AlessandroAU/Chorus32-ESP32LapTimer/data/laptimer comparison.pdf

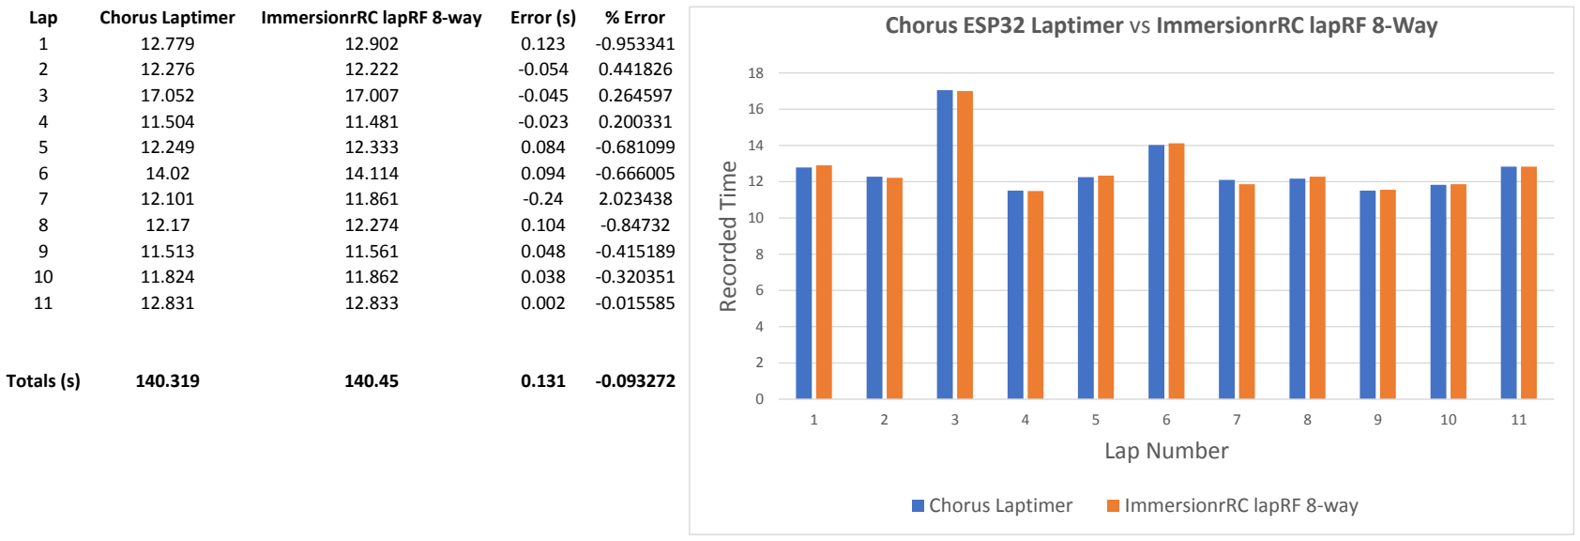
[picture p8: figure]
Lap; Chorus Laptimer; ImmersionrRC lapRF 8-way; Error (s); % Error; Totals (s); Recorded Time; Lap Number

### Chorus ESP32 Laptimer vs ImmersionrRC lapRF 8-Way
