AlessandroAU/Chorus32-ESP32LapTimer/img/hardwareImage1.png

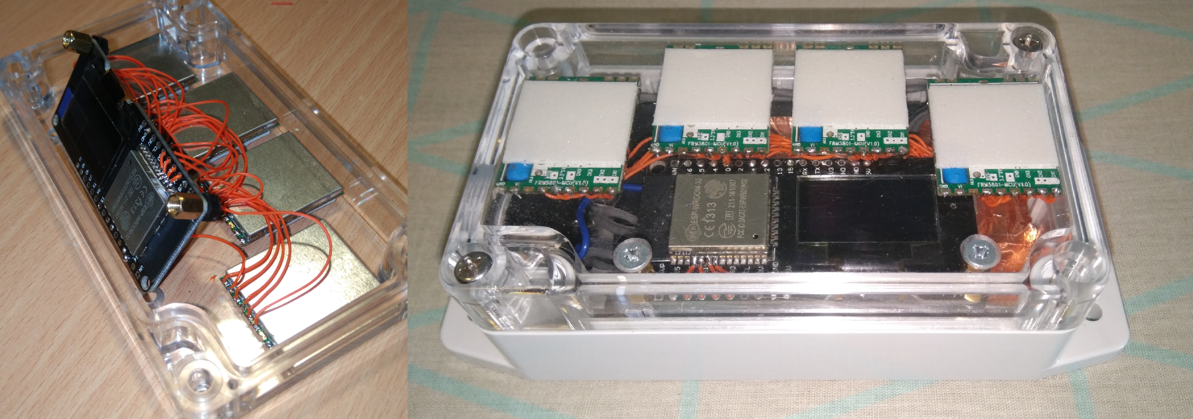
img/hardwareImage1.png
