AlessandroAU/Chorus32-ESP32LapTimer/img/HardwareImage2.png

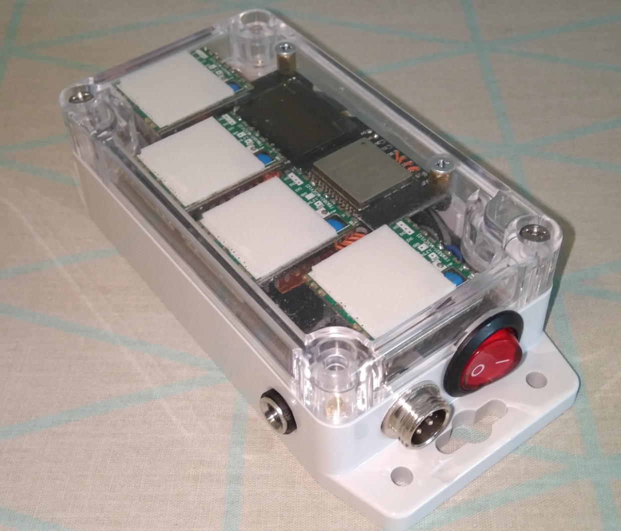
img/HardwareImage2.png
