AlessandroAU/Chorus32-ESP32LapTimer/img/schematic2.png

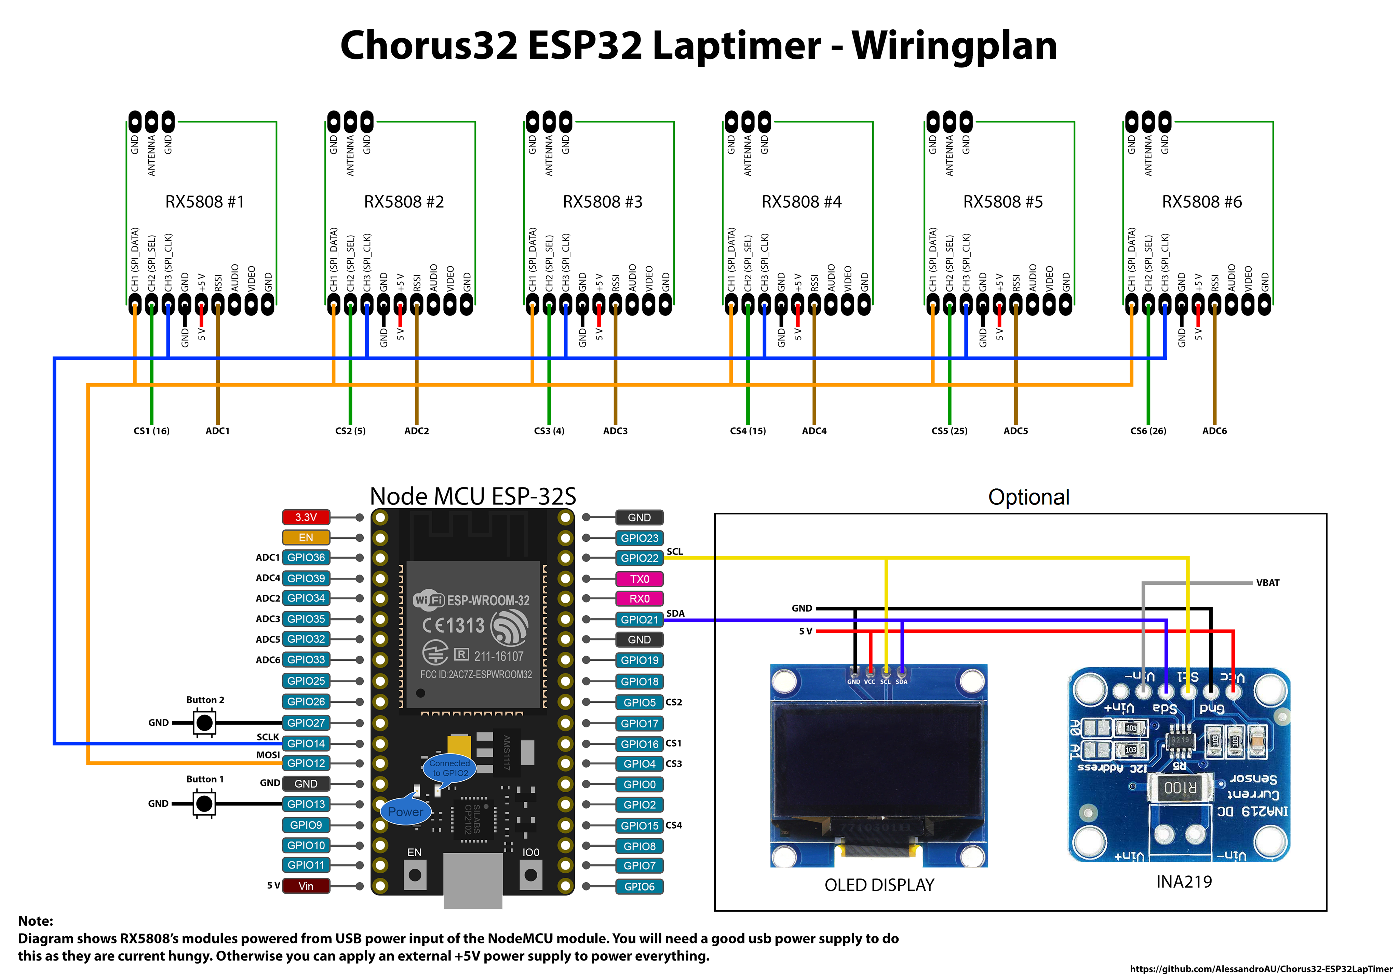
img/schematic2.png
