AlessandroAU/Chorus32-ESP32LapTimer/pcb/JyeSmith/PCBV2.1/PCB-2.1 - Patch Wire.png

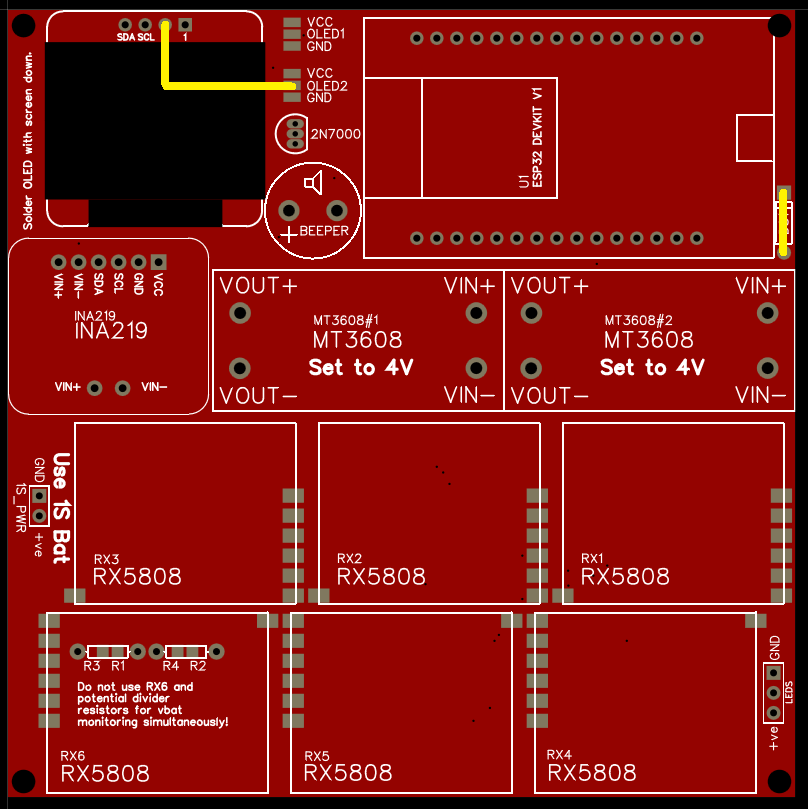
pcb/JyeSmith/PCBV2.1/PCB-2.1 - Patch Wire.png
