AlessandroAU/Chorus32-ESP32LapTimer/pcb/JyeSmith/PCBV2.1/Schematic-V2.1.png

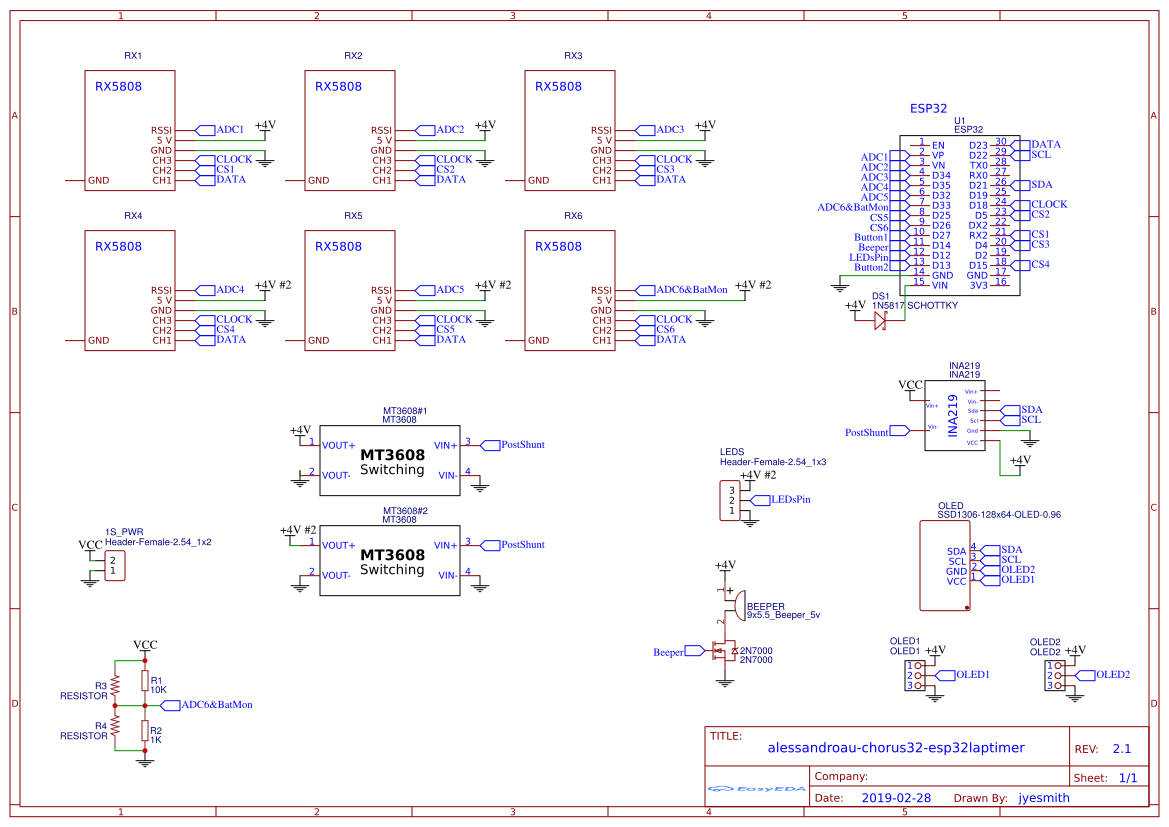
pcb/JyeSmith/PCBV2.1/Schematic-V2.1.png
