AlessandroAU/Chorus32-ESP32LapTimer/pcb/JyeSmith/PCBV2.2/PCB-2.2.png

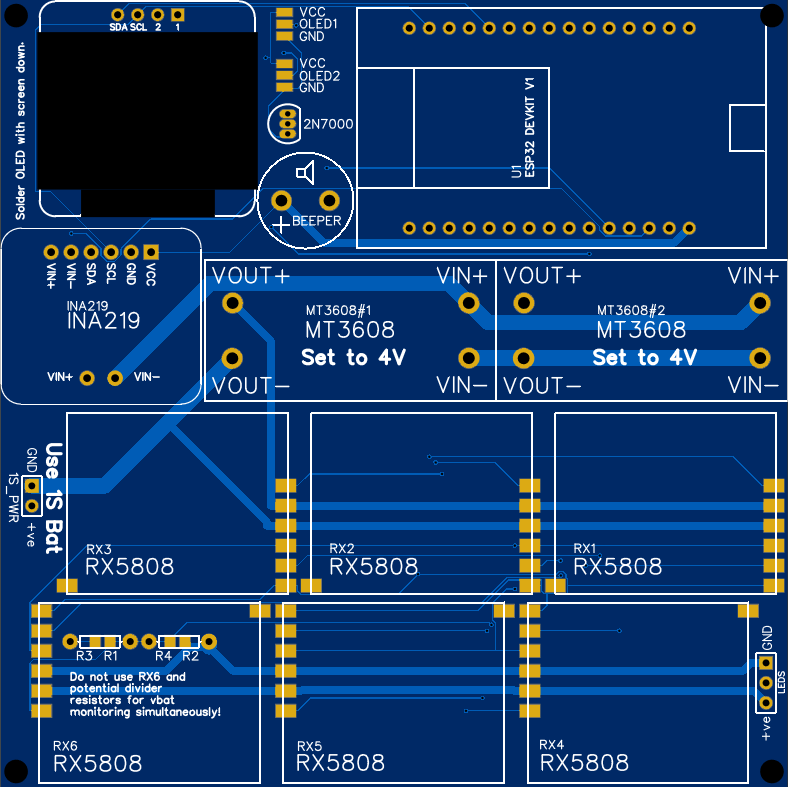
pcb/JyeSmith/PCBV2.2/PCB-2.2.png
