AlessandroAU/Chorus32-ESP32LapTimer/img/wiring.png

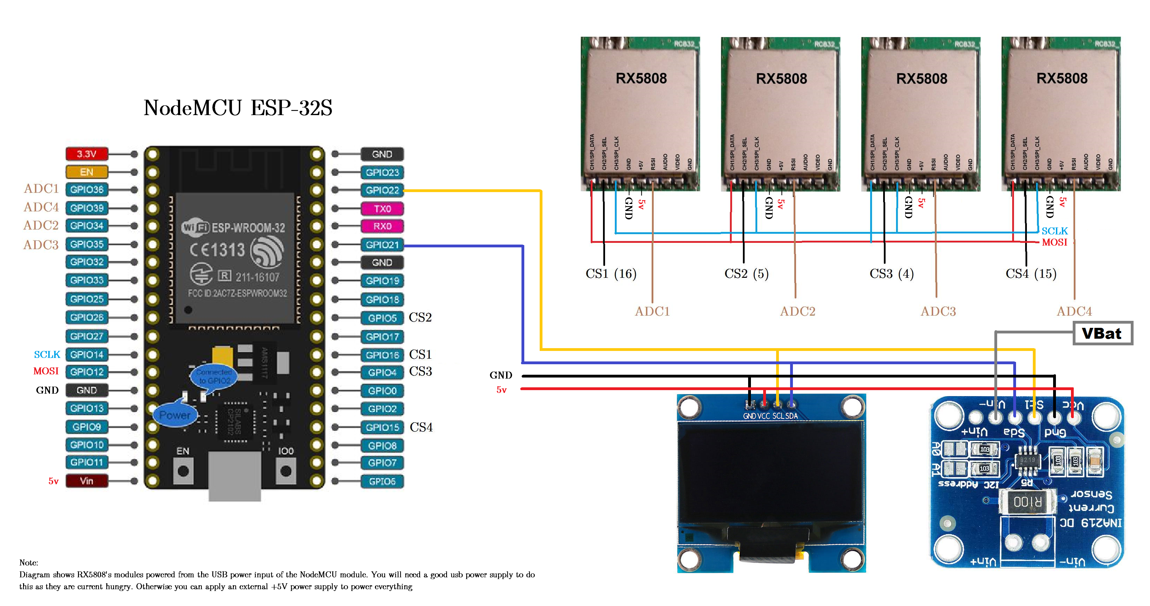
img/wiring.png
