AlessandroAU/Chorus32-ESP32LapTimer/(threads)

Thread 1 (2018-12-01):

Wifi drop

mmoustache, 2018-12-01:
Hi, after flashing scetch in Network manager i see Chorus LapTimer wifi. Connecting, and after 2 second my connection is dropping and phone trying another wifi net. Im Using DOIT ESP32 DEVKIT 1.
My flash log is below:

 Build options changed, rebuilding all
Archiving built core (caching) in: /var/folders/vh/7yvqz7hs4mb3hx6h7yhhwkgh0000gn/T/arduino_cache_787905/core/core_esp32_esp32_esp32_PSRAM_disabled,PartitionScheme_min_spiffs,FlashMode_qio,FlashFreq_80,FlashSize_4M,UploadSpeed_115200,DebugLevel_none_c000cfe2de910e434d508ffe474b5bc9.a
Sketch uses 1328918 bytes (67%) of program storage space. Maximum is 1966080 bytes.
Global variables use 82732 bytes (25%) of dynamic memory, leaving 244948 bytes for local variables. Maximum is 327680 bytes.
esptool.py v2.3.1
Connecting........__
Chip is ESP32D0WDQ6 (revision 1)
Features: WiFi, BT, Dual Core
Uploading stub...
Running stub...
Stub running...
Configuring flash size...
Auto-detected Flash size: 4MB
Compressed 8192 bytes to 47...

Writing at 0x0000e000... (100 %)
Wrote 8192 bytes (47 compressed) at 0x0000e000 in 0.0 seconds (effective 8221.8 kbit/s)...
Hash of data verified.
Compressed 15072 bytes to 9733...

Writing at 0x00001000... (100 %)
Wrote 15072 bytes (9733 compressed) at 0x00001000 in 0.9 seconds (effective 139.9 kbit/s)...
Hash of data verified.
Compressed 1329056 bytes to 779928...

Writing at 0x00010000... (2 %)
Writing at 0x00014000... (4 %)
Writing at 0x00018000... (6 %)
Writing at 0x0001c000... (8 %)
Writing at 0x00020000... (10 %)
Writing at 0x00024000... (12 %)
Writing at 0x00028000... (14 %)
Writing at 0x0002c000... (16 %)
Writing at 0x00030000... (18 %)
Writing at 0x00034000... (20 %)
Writing at 0x00038000... (22 %)
Writing at 0x0003c000... (25 %)
Writing at 0x00040000... (27 %)
Writing at 0x00044000... (29 %)
Writing at 0x00048000... (31 %)
Writing at 0x0004c000... (33 %)
Writing at 0x00050000... (35 %)
Writing at 0x00054000... (37 %)
Writing at 0x00058000... (39 %)
Writing at 0x0005c000... (41 %)
Writing at 0x00060000... (43 %)
Writing at 0x00064000... (45 %)
Writing at 0x00068000... (47 %)
Writing at 0x0006c000... (50 %)
Writing at 0x00070000... (52 %)
Writing at 0x00074000... (54 %)
Writing at 0x00078000... (56 %)
Writing at 0x0007c000... (58 %)
Writing at 0x00080000... (60 %)
Writing at 0x00084000... (62 %)
Writing at 0x00088000... (64 %)
Writing at 0x0008c000... (66 %)
Writing at 0x00090000... (68 %)
Writing at 0x00094000... (70 %)
Writing at 0x00098000... (72 %)
Writing at 0x0009c000... (75 %)
Writing at 0x000a0000... (77 %)
Writing at 0x000a4000... (79 %)
Writing at 0x000a8000... (81 %)
Writing at 0x000ac000... (83 %)
Writing at 0x000b0000... (85 %)
Writing at 0x000b4000... (87 %)
Writing at 0x000b8000... (89 %)
Writing at 0x000bc000... (91 %)
Writing at 0x000c0000... (93 %)
Writing at 0x000c4000... (95 %)
Writing at 0x000c8000... (97 %)
Writing at 0x000cc000... (100 %)
Wrote 1329056 bytes (779928 compressed) at 0x00010000 in 69.0 seconds (effective 154.0 kbit/s)...
Hash of data verified.
Compressed 3072 bytes to 144...

Writing at 0x00008000... (100 %)
Wrote 3072 bytes (144 compressed) at 0x00008000 in 0.0 seconds (effective 1452.8 kbit/s)...
Hash of data verified.

Leaving...
Hard resetting via RTS pin...

AlessandroAU, 2018-12-01:
Hi, you upload the serial log when you try to connect to WiFi?

mmoustache, 2018-12-02:
Hi, serial log says that, maybe it happend beacuase i justa flashed ESP32 and not connected receivers?

Ready! Open http://esp32-webupdate.local in your browser
Ready
IP address: 0.0.0.0
setModuleChannelBand
0,4
32
a = 5740
setModuleChannelBand
2,4
34
a = 5780
setModuleChannelBand
4,4
36
a = 5820
setModuleChannelBand
6,4
38
a = 5860
Guru Meditation Error: Core  1 panic'ed (Cache disabled but cached memory region accessed)
Core 1 register dump:
PC      : 0x400dd628  PS      : 0x00060034  A0      : 0x800817e4  A1      : 0x3ffc0bd0
A2      : 0x00000000  A3      : 0x20000000  A4      : 0x00000400  A5      : 0x3ffc5bb4
A6      : 0x3ffc4d40  A7      : 0xffffffff  A8      : 0x80081290  A9      : 0x3ffc0bb0
A10     : 0x00000000  A11     : 0xffffffff  A12     : 0x3ffd69ec  A13     : 0x000000ff
A14     : 0x3ffc63c0  A15     : 0x00060a23  SAR     : 0x00000014  EXCCAUSE: 0x00000007
EXCVADDR: 0x00000000  LBEG    : 0x00000000  LEND    : 0x00000000  LCOUNT  : 0x00000000
Core 1 was running in ISR context:
EPC1    : 0x40082f73  EPC2    : 0x00000000  EPC3    : 0x00000000  EPC4    : 0x400dd628

Backtrace: 0x400dd628:0x3ffc0bd0 0x400817e1:0x3ffc0bf0 0x40081cd9:0x3ffc0c10 0x40082f70:0x00000000

Rebooting...

AlessandroAU, 2018-12-02:
Seems to be crashing during the ISR loop when reading ADCs, should not be happening. I will have a look.

AlessandroAU, 2018-12-07:
Appears to be a conflict between wifi and bluetooth stacks, fixed for now by disabling BLE by default in latest commit. BLE can be re-enabled by uncommenting compiler option //#define BluetoothEnabled

Closed 2018-12-07.

Thread 2 (2019-02-03):

File ESPmDNS.h is missing for compile/upload

mottex, 2019-02-03:
I try to upload the laptimer code, but arduino ide - gives the following error message:

ESP32LapTimer:7:21: error: ESPmDNS.h: No such file or directory

compilation terminated.

exit status 1
ESPmDNS.h: No such file or directory

Thanks for your help

AlessandroAU, 2019-02-03:
You will need to install all the libraries required. You should be able to do it through the library manager
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

mottex, 2019-02-03:
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

Unfortunately it is not shown.... any other suggestions?

AlessandroAU, 2019-02-03:
I would do I fresh install of the esp32 files through board manager to ensure you're not having issues because of old code

mottex, 2019-02-03:
Thanks for your help! I have internet connection problems, which caused the above message.

Now, i got the message - comms.h -
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
 is missing. Do i have to include an other library? (the File comms.h is in the project folder).

AlessandroAU, 2019-02-04:
You need to make sure that all the files are in the same folder and that the folder is called "ESP32LapTimer" ie same as the main arduino .ino file.

mottex, 2019-02-04:
Thanx allessandro! Can be closef

Closed 2019-02-04.

Thread 3 (2019-02-05):

Hardware

LuisDiazUgena, 2019-02-05:
Hi!

I was wondering if you can share a link to the board that you're using to built this.

TY.

AlessandroAU, 2019-02-07:
Hi, most ESP32 boards will work. I used an OLED board but I would recommend a standard nodeMCU ESP-32s as it will probably become the standard.

LuisDiazUgena, 2019-02-07:
Ok, no problem. Will take a look at which boards are available and choose one. I think maybe it will be interesting to make a custom pcb board to solder on the ESP32 IC and the VRX. Also, by adding some simple power management stuff, could be a nice project to work with.

Also, could be nice to keep info about how to create and wire up the project.

AlessandroAU, 2019-02-08:
Hi, I added a wiring diagram for the NodeMCU ESP32s
https://github.com/AlessandroAU/Chorus32-ESP32LapTimer/blob/master/wiring.png

LuisDiazUgena, 2019-02-08:
Thanks

shirishyc, 2019-02-08:
Thanks

Closed 2019-02-08.

Thread 4 (2019-02-07):

Connection Diagram needed

shirishyc, 2019-02-07:
Hi

I want to use an OLED board for this Project.
So can you provide Connection diagram for connecting ESP32 and RX5808 module

Sorry I don't know how to contact you for further Info about this Project.
Waiting for your reply

Thanks in Advance
SHIRISH

LuisDiazUgena, 2019-02-07:
Regarding the oled:

For connecting the OLED you shoul use the rigth port on the node MCU, I think most of oled uses SCL/SDA to interface with the OLED.

Google for "your_board_name_here pinout" and look for SCL/SDA.

AlessandroAU, 2019-02-08:
Hi, recommend you don't use the esp32 oled board because not all the ADC pins are broken out. At the moment the oled does nothing. The NodeMCU ESP32s is easier to wire up. I have added a wiring diagram to the main page.

https://github.com/AlessandroAU/Chorus32-ESP32LapTimer/blob/master/wiring.png

shirishyc, 2019-02-08:
Thanks a lot for updating Git repo with wiring diagram.
Will work accordingly..

shirishyc, 2019-02-10:
Hi,
I have compiled uploaded into ESP32.
But having small question, What file need to upload in WebServer.
Im unble to figure out.. Can you let me know sample file for the same.. or can you upload into repo.
Im attaching screenshot for ref.

Waiting for reply
Thanks
SHIRISH

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

AlessandroAU, 2019-02-10:
You don't need to upload anything, that is for a future version where you will be able to update the firmware by uploading a file.

It should be working, check to see if you can make a connection with the app.

shirishyc, 2019-02-10:
Ok Great Thanks.
Im able to connect to App. But unable to add pilots name..
is I'm missing something to do..

AlessandroAU, 2019-02-10:
Can you show me the serial console in Arduino when you connect to the board from the app?

AlessandroAU, 2019-02-12:
Did you get it working?

shirishyc, 2019-02-13:
Yes.. Its Perfectly Working Fine..
I just mess with some Wires thts why Unable to do.!
But Now working Fine.

Thanks for Awesome Code.

1que Can We run web server from ESP32

AlessandroAU, 2019-02-13:
This is possible, but it would be alot of work and web design is not my area of expertise. I think it is too hard for the moment.

marcfon, 2020-04-30:
In case someone is searching for the wiring diagram... The link has changed to this:  https://github.com/AlessandroAU/Chorus32-ESP32LapTimer/blob/master/img/wiring.png

Closed 2019-02-13.

Thread 23 (2019-03-07):

Unable to connect to wifi configurator

LuisDiazUgena, 2019-03-07:
Hi!

I was trying to use this project and I'm not being able to connect to the wifi configurator.

I've flashed the code with no issues. Also flashed href=\"https://github.com/me-no-dev/arduino-esp32fs-plugin pluging and uploaded esp32 sketch data.

I can connect to wifi AP, but android doesn't ask me to sign in the network. I've looked into the code, and the wifi AP seems to be 192.168.1.4, so I've tried to log using chrome, not luck again.

Here is my serial monitor output.
```
ets Jun  8 2016 00:22:57

rst:0x1 (POWERON_RESET),boot:0x13 (SPI_FAST_FLASH_BOOT)
configsip: 0, SPIWP:0xee
clk_drv:0x00,q_drv:0x00,d_drv:0x00,cs0_drv:0x00,hd_drv:0x00,wp_drv:0x00
mode:DIO, clock div:1
load:0x3fff0018,len:4
load:0x3fff001c,len:1100
load:0x40078000,len:10088
load:0x40080400,len:6380
entry 0x400806a4
[V][esp32-hal-i2c.c:1483] i2cInit(): num=0 sda=21 scl=22 freq=0
[V][esp32-hal-i2c.c:1677] i2cSetFrequency(): freq=100000Hz
[V][esp32-hal-i2c.c:1692] i2cSetFrequency(): cpu Freq=240Mhz, i2c Freq=100000Hz
[V][esp32-hal-i2c.c:1698] i2cSetFrequency(): Fifo delta=1
[V][esp32-hal-i2c.c:1677] i2cSetFrequency(): freq=700000Hz
[V][esp32-hal-i2c.c:1692] i2cSetFrequency(): cpu Freq=240Mhz, i2c Freq=700000Hz
[V][esp32-hal-i2c.c:1698] i2cSetFrequency(): Fifo delta=5
Booting....
EEPROM LOADED
6
6
[V][esp32-hal-i2c.c:1483] i2cInit(): num=0 sda=21 scl=22 freq=0
[V][esp32-hal-i2c.c:1677] i2cSetFrequency(): freq=701754Hz
[V][esp32-hal-i2c.c:1692] i2cSetFrequency(): cpu Freq=240Mhz, i2c Freq=701754Hz
[V][esp32-hal-i2c.c:1698] i2cSetFrequency(): Fifo delta=5
off
[D][WiFiGeneric.cpp:342] _eventCallback(): Event: 0 - WIFI_READY
[D][WiFiGeneric.cpp:342] _eventCallback(): Event: 14 - AP_STOP
[E][WiFiSTA.cpp:211] begin(): connect failed!
[D][WiFiGeneric.cpp:342] _eventCallback(): Event: 2 - STA_START
[D][WiFiGeneric.cpp:342] _eventCallback(): Event: 2 - STA_START
[D][WiFiGeneric.cpp:342] _eventCallback(): Event: 13 - AP_START
[D][WiFiGeneric.cpp:342] _eventCallback(): Event: 13 - AP_START
on
HTTP server started
[E][WiFiClient.cpp:264] setOption(): 9
setModuleChannelBand
0,4
32
a = 5740
setModuleChannelBand
2,4
34
a = 5780
setModuleChannelBand
4,4
36
a = 5820
setModuleChannelBand
6,4
38
a = 5860
setModuleChannelBand
0,0
0
a = 5658
setModuleChannelBand
7,0
7
a = 5917
Starting ADC reading task on core 1
Task created...
E (10695) event: mismatch or invalid event, id=63
E (10696) event: default event handler failed!
[D][WiFiGeneric.cpp:342] _eventCallback(): Event: 15 - AP_STACONNECTED
[D][WiFiGeneric.cpp:342] _eventCallback(): Event: 15 - AP_STACONNECTED
dhcps: send_offer>>udp_sendto result 0
[D][WiFiGeneric.cpp:342] _eventCallback(): Event: 17 - AP_STAIPASSIGNED

```

JyeSmith, 2019-03-07:
The address is http://192.168.4.1/

See how you go with that :)

LuisDiazUgena, 2019-03-07:
Nope, same behaviour :(

AlessandroAU, 2019-03-07:
Hi Luis,

Sorry this was my fault, was trying to debug a separate issue and left some code in that shouldn't have been there. I just fixed it, try it again :)

LuisDiazUgena, 2019-03-08:
Yes! It's working now :) Now it's asking to sign in the network and I can see the webpage.

Still not able to see the site using the url 192.168.4.1

If you leave the page, it's imposible to see it until you turn off and on wifi connection.

Closed 2019-03-08.

Thread 28 (2019-03-08):

Fast scanning to reduce vrx

LuisDiazUgena, 2019-03-08:
Would be possible to implement a mode in which esp32 makes the vrx jumps through channels really quick?

That way it would be possible to reduce the number of vrx to complete the project.

JyeSmith, 2019-03-08:
Yes, but no :)

The RX5808 module takes about 30ms to settle and output a sensible RSSI after changing channels.  For a quad moving at 100km/h in 30ms it moves 83cm, so that now becomes your timing resolution.  Do this for 6 channels and the quads RSSI is now only being sampled every 5m.  At that distance a quad could pass through the timing gate and be missed completely.

LuisDiazUgena, 2019-03-11:
That's a shame. Will be a great option to reduce the cost and size.. but if it's not possible, it's not possible. Thanks

bseishen, 2019-03-30:
Both TBS and Immersions personal tracker offerings both use one module. I think this is worth perusing even loss of resolution. Might not be a good solution for large races, but practice days 1-4 pilots or even tinywhoop might be a good idea.
According to Immersions laprf app:
1 Pilot - 30ms/160kmh
2 - 60/90
3- 90/75
4-120/50

Closed 2019-03-11.

Thread 29 (2019-03-08):

Json package with data

LuisDiazUgena, 2019-03-08:
I was thinking about a json rest api to communicate to and from apps.

Could be really easy to create and android app that allows to configurate the project instead of using a webserver.

The app also could be used to visualise lap times.

I have already started digging into how to create the json parser in the esp32, and got plenty of experience in software developing.

Will be nice if you can point out what needs to be changed with the app. I'm thinking about:

Timer active
Frecuency of video
Vbat scale

AlessandroAU, 2019-03-09:
If you want to develop this you are welcome too, but why would this be better than a websever? You'll need to make the user download another app.

LuisDiazUgena, 2019-03-11:
Yeah, I was thinking about making it easier, but indeed will be more hard to develope, and a web server is already cross platform.

Closed 2019-03-11.

Thread 30 (2019-03-08):

Channel change

LuisDiazUgena, 2019-03-08:
Hi!

How do you modify channels assigned to each ADC?

JyeSmith, 2019-03-08:
You can do that here https://github.com/AlessandroAU/Chorus32-ESP32LapTimer/blob/master/ESP32LapTimer/HardwareConfig.h

LuisDiazUgena, 2019-03-08:
Sorry, I mean VTX channels

JyeSmith, 2019-03-08:
https://github.com/AlessandroAU/Chorus32-ESP32LapTimer/blob/master/ESP32LapTimer/RX5808.ino#L105

LuisDiazUgena, 2019-03-11:
Thanks!

Closed 2019-03-11.

Thread 31 (2019-03-11):

Changing channel from webserver

LuisDiazUgena, 2019-03-11:
Hi!

I started to create the interface for updating band and channel from webserver:

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

The select items are showing bands and channels and will be showed with the parsed value from the configuration `data.NumRXs`. So, ie: if data.NumRXs = 4, only 4 VRX configuration will be showed.

Channels can be chossed from 1 to 8 and bands ussing their "names":

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

As I click the update [button](https://github.com/AlessandroAU/Chorus32-ESP32LapTimer/blob/76596c2e07e1e9246a0b7944631699c094e3b582/ESP32LapTimer/data/index.html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) on index, the url will be:

`updateGeneral?NumRXs=7&band1=R&channel1=1&band2=R&channel2=2&band3=R&channel3=3&band4=R&channel4=4&band5=R&channel5=5&band6=R&channel6=6`

Where each band and channel are sended ussing the same pattern.

I assume  data transfer is going to be recieved at [this line in webserver.ino](https://github.com/AlessandroAU/Chorus32-ESP32LapTimer/blob/76596c2e07e1e9246a0b7944631699c094e3b582/ESP32LapTimer/WebServer.ino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)

And needed to be stored in the eepromsettings. I think they need to be stored in RXBand, RXChannel and RXFrequencies.

I don't have the project with me, so I can't test it out. but will do during this week and let you know.

If you got any suggestions, please, feel free to contact me.

JyeSmith, 2019-03-11:
Nice.

My preference would be for buttons like the app but can live with drop down boxes.

LuisDiazUgena, 2019-03-11:
Can you post an image to show how it's this done in the app?

JyeSmith, 2019-03-11:
You can see a screen shot here.

https://play.google.com/store/apps/details?id=app.andrey_voroshkov.chorus_laptimer

LuisDiazUgena, 2019-03-12:
Thanks @JyeSmith, I think that's a good idea as well. Will try to implement it, but for now I think it's ok with the dropdown.

AlessandroAU, 2019-07-07:
This is implemented now :)

Closed 2019-07-07.

Thread 32 (2019-03-11):

Webserver - Error

mottex, 2019-03-11:
Hi Allesandro

I tried to get the webserver runnig, when im doing the sketch data upload - the following message will display:

Arduino: 1.8.7 (Windows 10), Board: "ESP32 Dev Module, Disabled, Minimal SPIFFS (Large APPS with OTA), 240MHz (WiFi/BT), QIO, 80MHz, 4MB (32Mb), 921600, None"

[SPIFFS] data   : C:\Users\motte\OneDrive\Dokumente\Chorus Lap Timer\19-03-10 Chorus32-ESP32LapTimer-master\Chorus32-ESP32LapTimer-master\ESP32LapTimer\data
[SPIFFS] start  : 4001792
[SPIFFS] size   : 188
[SPIFFS] page   : 256
[SPIFFS] block  : 4096
/assets/css/images/overlay1.png

/assets/css/images/overlay2.png

/assets/css/images/overlay3.svg

/assets/css/images/overlay4.svg

/assets/css/main.css

/assets/css/slider.css

/err.html

/ESP32FS.java

/flag.svg

/GetStaticVars.js

/index.html

/index_.html

/jquery-3.3.1.min.js

SPIFFS_write error(-10001): File system is full.

error adding file!

SPIFFS Create Failed!
[SPIFFS] data   : C:\Users\motte\OneDrive\Dokumente\Chorus Lap Timer\19-03-10 Chorus32-ESP32LapTimer-master\Chorus32-ESP32LapTimer-master\ESP32LapTimer\data
[SPIFFS] start  : 4001792
[SPIFFS] size   : 188
[SPIFFS] page   : 256
[SPIFFS] block  : 4096
/assets/css/images/overlay1.png

/assets/css/images/overlay2.png

/assets/css/images/overlay3.svg

/assets/css/images/overlay4.svg

/assets/css/main.css

/assets/css/slider.css

/err.html

/ESP32FS.java

/flag.svg

/GetStaticVars.js

/index.html

/index_.html

/jquery-3.3.1.min.js

SPIFFS_write error(-10001): File system is full.

error adding file!

SPIFFS Create Failed!

This report would have more information with
"Show verbose output during compilation"
option enabled in File -> Preferences.

AlessandroAU, 2019-03-13:
Hi mottex,

Firstly, you don't need the ESP32FS.java in the data directory. I assume you put it there by mistake when you were trying to install the ESP32 data uploading tool. You just need to put the .jar in the arduino program folder. Nothing else goes into the data folder.

I think you are following old instructions, you are compiling with "Minimal SPIFFS (Large APPS with OTA)" , this was needed when we were using Bluetooth. With that option the file-space for the webserver is limited and the files don't fit, that is the error you see. Since BLE is disabled for now just compile with Partition Scheme => Default and reuploaded SPIFFS. It should work.

mottex, 2019-03-14:
Sorry was my fault! Thanks for your help

Closed 2019-03-14.

Thread 34 (2019-03-13):

Connect to Chorus RF Laptimer

LuisDiazUgena, 2019-03-13:
Hi!

I've been trying to use the chorus RF laptimer App as listed on the README, and I can't see any of the info in the app.

I connect my android device to the Chorus32 network and signed into the network. I can see and change the setup. If I go to the Chorus RF Laptimer app, I can connect to the network (and it toast a "connected to 192.168.4.1". But there is nothing at all on the Freq and Pilots tabs.

On Race there is two buttons "calibrate timers" and "start race", which are disabled.

I've seen that in comms.ino there is a lot of functions related to chorus API, so that make me think that it's already implemented, but I'm not sure if I'm missing something.

Thanks.

AlessandroAU, 2019-03-14:
Its working fine for me, what does your serial console output look like when you connect with the app?

AlessandroAU, 2019-03-14:
Luis, I just tried with a copy of your git and it works for me.

Perhaps your eeprom has bad values? Do you have numReceivers > 0?

LuisDiazUgena, 2019-03-14:
Wifi connection:

```
E (23967) event: mismatch or invalid event, id=63
E (23967) event: default event handler failed!
dhcps: send_offer>>udp_sendto result 0
```
After that, nothing happens when connecting to the app.

AlessandroAU, 2019-03-14:
That's really odd, can you try with another device? Maybe tell android to forget the network and try again?

LuisDiazUgena, 2019-03-14:
> That's really odd, can you try with another device? Maybe tell android to forget the network and try again?

Already did. Forgot network and removed app. Nothing changes (Android 9)

Instaled in other devide. Same behaviour (Android 7)

I'm sure that in both devices the app has all the permisions enabled.

AlessandroAU, 2019-03-14:
After you are directed to the captive portal webserver do you click 'ok' in android to accept the connection?

LuisDiazUgena, 2019-03-14:
> After you are directed to the captive portal webserver do you click 'ok' in android to accept the connection?

Got no message like that, but I can hit the menu icon and tell android to use the network.  The option pointed by the arrow translates as "Use this network at it is"

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

AlessandroAU, 2019-03-14:
If select 'use as is' and try the app again does anything change?

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

AlessandroAU, 2019-03-14:
Just checking,

In the app; I just want to check that you are clicking the 3 dots at the top right and then selecting 'connect via wifi' ?

LuisDiazUgena, 2019-03-14:
> Just checking,
>
> In the app; I just want to check that you are clicking the 3 dots at the top right and then selecting 'connect via wifi' ?

Yes. (I work at Software developmnt so I know that you have to do this kind of questions, don't worry for asking)

LuisDiazUgena, 2019-03-14:
Just tried to connect again. Android just asked me:  This network has no internet connection, do you want to use it? Just clicked yes, and its works :)

Closed 2019-03-14.

Thread 47 (2019-04-03):

RSSI on RX4 spiking a bit with PCB v2

mike-levenick, 2019-04-03:
I've noticed that the ADC4 value on my new build is spiking around a bit. With nothing transmitting, RX 1-3 report RSSI bouncing between ~78-83ish, fluctuating by 5 or so.

RX4 reports RSSI bouncing from 78 up to 110 or more at times, briefly, and then back down. I've also noticed the OLED will show that bar fill _completely_ (like, off the chart) for a brief moment and then settle down--although in-app RSSI monitoring does not show those massive spikes.

After seeing similar interference from the jumper pads under the OLED, I'm wondering if it has something to do with a voltage rail near the ADC4 trace or something, since my point-to-point build does not exhibit this behavior. Especially since RX4 is powered from a different power rail than RX 1-3 are (the upper buck converter vs the lower one).

I will be double checking all my solder joints, and also try a different ESP32 (I bought a 3 pack, and socketed the ESP32 into the board for easy swapping), but was wondering if anyone else has seen similar behavior. Perhaps a different type of filtering or something?

mike-levenick, 2019-04-03:
I will also try desoldering the lower power converter and jumping power over from RX3 to RX4 to see if performance is different.

AlessandroAU, 2019-04-04:
The massive spikes on the OLED are actually an artifact, in line 89 of OLED.ino we map the RSSI values to the sliders. To make best use of the space the minimum value of 50 is used. So if the RSSI drops below 50 the mapping function kind of breaks and it shows it as 100%.

Regarding the jumping around, I can't quite say yet, are you using the same RX5808 modules as your point-to-point setup?

JyeSmith, 2019-04-04:
@mike-levenick can you try swapping Rx 4 with one of the others and see if the problem follows?

mike-levenick, 2019-04-04:
@JyeSmith and @AlessandroAU I will troubleshoot on my end for the jumping RSSI. I believe it's likely hardware related on my end.

That said, I resolved the OLED artifacting for RSSI below 50 in PR48 https://github.com/AlessandroAU/Chorus32-ESP32LapTimer/pull/48

mike-levenick, 2019-04-05:
Resolved in commit https://github.com/AlessandroAU/Chorus32-ESP32LapTimer/commit/b3f9c253f969e188bc00d22fd3b7da0a042e4369

Closed 2019-04-05.

Thread 49 (2019-04-05):

Multiplexing channels to reduce RX5808 Count.

bseishen, 2019-04-05:
Both TBS and Immersions personal tracker offerings both use one module. I think this is worth perusing even loss of resolution. Might not be a good solution for large races, but practice days 1-4 pilots or even tinywhoop might be a good idea.
According to Immersions laprf app:
1 Pilot - 30ms/160kmh
2 - 60/90
3- 90/75
4-120/50

Plus battery life will be better, lower price, reduced BOM count, and smaller form factor.

JyeSmith, 2019-04-05:
Alright, I'll add it in the next couple of days ☺

Are you able to test when I create a pull?

bseishen, 2019-04-08:
Sure thing, I have everything in stock and can whip some hardware up pretty quick.

Thread 50 (2019-04-05):

RSSI calibration setup

JyeSmith, 2019-04-05:
A calibration setup is going to be needed to optimise the Rx multiplexing feature.  This is the same as what Fatshark modules do e.g. checkout https://github.com/sheaivey/rx5808-pro-diversity and how it normalised a max and min RSSI.

Multiplexing a single Rx to multiple frequencies will work as is using the Rx raw RSSI and current threshold method.  But let's say you have 6 Rx modules and want to run 8 quads?

You could use all 6 Rx modules to measure quads 1-6 RSSI, and then use Rx 1-2 to measure quad 7-8.  This will also work with current raw RSSI readings and threshold.  But you now have 60ms between every quad RSSI measurement.

Or we can use Rx 1-6 to measure quad 1-6, then Rx 1-6 for quad 7,8,1,2,3,4, then Rx 1-6 for quad 5,6,7,8,1,2, etc.  See how this drops the measurements time for each quad to 30ms with an occasional 60ms gap.

The problem being that quads will be measured using different Rx modules, so an RSSI calibration is needed.

How?  Add a start Calibration button to the web server.  With a quad set to 25mW 1m from the laptimer the Rx modules will sweep the frequency table looking for high and low values.  These are used to map the raw RSSI readings.

Closed 2019-04-15.

Thread 54 (2019-04-08):

[feature Request] Reset eeprom defaults button on webserver

JyeSmith, 2019-04-08:

Closed 2019-04-15.

Thread 59 (2019-04-13):

Connection with LiveTime via WiFi..

kmitchel, 2019-04-13:
Use with LiveTime requires serial correct?

AlessandroAU, 2019-04-13:
There is a bug with the ESP causing TCP disconnects that still hasn't been fixed
https://github.com/espressif/arduino-esp32/issues/1921

So Native TCP connection in livetime doesn't work.

You can use a UDP -> serial port emulator application to use it over WiFi with livetime.

https://www.netburner.com/download/virtual-comm-port-driver-windows-xp-10/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

kmitchel, 2019-04-13:
Working.  Excellent!! TY.

Closed 2019-04-13.

Thread 61 (2019-04-25):

Multifunction use, long range omni diversity (passive antenna tracker)

Dropsleutel, 2019-04-25:
If the software could set all 6 modules, to the same Rx frequency and select the strongest output, via a video switch f.i. 2x CD4066, the unit could be also used as a long range multi diversity basestation with several hi gain antenna.

As here:
https://hobbyking.com/en_us/quanum-overlord-5-8ghz-40ch-6-antenna-diversity-receiver-w-raceband.html
Fi combined with these:
https://www.maartenbaert.be/quadcopters/antennas/triple-feed-patch-array-antenna/

mike-levenick, 2019-04-25:
I've looked into doing this as a separate project, but the hardware would be a fair bit different. You would need some sort of switching mosfet or relay to flip between the video signals based off RSSI.

Definitely a project worth looking into, but I'm not sure if it's within the scope of Chorus32. Others may have other opinions tho.

Dropsleutel, 2019-04-25:
The analog video and audio switching there are simple solutions, it is far from complicated!
The easy way would be to use an 8 channel analog video switch (Mux) MAX4312, which is controlled via 3pins in BCD, see example here:

http://www.vwlowen.co.uk/radio/videoswitch3/index.htm
You could use 2 more of these switches for audio left and right.

AlessandroAU, 2019-04-25:
Its a good idea, and very doable. You can cut out 90% of the code. However, modern receivers have some 'other' fancy tricks like vsync reconstruction we can't currently do.

I'm working on something to blow traditional RSSI switching RX's out of the water anyway.

http://www.eevblog.com/forum/projects/image-synthesizing-dsp-receiver-for-analog-fpv-video/

Dropsleutel, 2019-04-25:
hmm very interesting indeed :) Maybe this circuitry can be also of interest written in Dutch though:)
Called SyncSmurf, it is basically a PLL circuitry, mainly used for receiving weak and noisy ATV signals.
It keeps, generates a strong sync even when signal is bad.

Would be very nice to have a multipurpose unit, can be used for racetiming or for video reception etc

I hope project gets some more attention, because seriously nicejob!

Thread 93 (2019-07-24):

OTA Programming

JyeSmith, 2019-07-24:
Makes sense we should have this and will be useful those of us that bury our boards in a case.

Pulls could also be accompanied with a .bin for easy uploading and testing.

AlessandroAU, 2019-07-24:
Doesn't the web interface already do this?

JyeSmith, 2019-07-24:
So it is...

Ive just never used it dueing dev, but will be useful in field testing.

Closed 2019-07-24.

Thread 101 (2020-02-02):

USB plus Batt connect fries the ESP32

pascalnl, 2020-02-02:
Mistakenly I connected the battery when USB cabel was attached.
It fried the regulator on the ESP32

swampmonster, 2020-03-25:
That sucks man, never fun when hardware explodes. Not quite sure if you want help with something or perhaps want us to put a warning about this?

pascalnl, 2020-03-25:
Hi Alessandro,

No. More as a warning. Don't try this at home. Sort off thing.

I made a mistake.

Fortunately. The weather is getting better. So I can use it to get faster.

--
Send from Android

Op wo 25 mrt. 2020 12:54 schreef swampmonster <notifications@github.com>:

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

swampmonster, 2020-03-25:
Alright man. Good to hear you're gonna get some practice in soon :)
Also; I'm not Alessandro :)

LuisDiazUgena, 2020-04-06:
Hi,

I think it depends on what your setup is. I've connected like this, using both the battery and the usb and I got no problem at all.

Thread 113 (2020-04-10):

Required hardware?

marcfon, 2020-04-10:
Can I just hook up an RX5808 to a ESP32 and run this project or do I need the PCB including all the other components?

By the way if there's a better place to ask questions like these please let me know!

marcfon, 2020-04-10:
Found the thread on [RCGroups](https://www.rcgroups.com/forums/showthread.php?2801815-Chorus-Laptimer-16-RSSI-5-8Ghz-track-system/)

Smeat, 2020-04-10:
The thread you linked is for the Chorus (no 32) project. The Arduino and ESP32 versions are two separate projects, which do support the same API, so all the client software is compatible between the two.
To answer your question: Yes an ESP32 and RX5808 is enough. You need some way to supply the required power though. The other components, like a display or buttons are completely optional.

We have a discord channel you can join: https://discord.gg/Ew3Gv3k

Closed 2020-04-10.

Thread 115 (2020-04-14):

[Feature request] Better lap detection

Smeat, 2020-04-14:
We are currently only using a threshold based approach, where we trigger a new lap as soon as the threshold is reached. I think I don't have to explain, why this isn't ideal.
I did some test with a simple max based approach, which showed a significant difference in time (about 50ms): https://github.com/Smeat/Chorus32-ESP32LapTimer/wiki/Data

The original project also has another trigger mode which might be worth a look

AlessandroAU, 2020-04-14:
I've had this idea but haven't tried it yet:

1. Use slightly lower threshold to get a small window of peak data, this would be a window of data where we know a lap is about to happen.

2. Take the time derivative to get the rate of change of RSSI and use the maximum of that to determine when the lap happened.

Thread 116 (2020-04-14):

[Feature request] Add beeper support

Smeat, 2020-04-14:
Seems like we have some beeper code, but it isn't really used anywhere.

A solution would require the use of "vTaskDelay" or a similar approach, which doesn't use a busy wait (aka "delay") as well as the implementation of the "sound" message to disable/enable the sound.

marcfon, 2020-07-16:
Would be nice to have an alarm when your battery voltage drops below a certain level.

Thread 117 (2020-04-15):

Wlan connection with activated Bluetooth not possible

Peschi90, 2020-04-15:
Hey Guys,
thanks for your project but i have one issue.
because i cant connect with the app over wifi, i activated bluetooth.
This works ok with the App but if i want to change something in the WIFI settings Page,
the Module reboot directly after i connect to the wifi Network, closed the wifi,start it again and dont show the page.
do you know something about this issue?

BR Peschi :)

Smeat, 2020-04-15:
Are you using v1.0 or the current master? What else did you change in the configuration, besides activating bluetooth?
I had some problems with bluetooth the last time I tested it, so you might try and disable that to see if that fixes the problem

Peschi90, 2020-04-15:
iam using the current master but flashed it over arduino Software. When i deactivate bluetooth the i cann connet to the wifi and get the settings page. i get this issue only if i activate the bluetooth in the hardwareconfig.h file.
the bluetooth connection is working with the app only the range is really poor.

Smeat, 2020-04-15:
Then I am guessing this is the same problem I encountered (https://github.com/Smeat/Chorus32-ESP32LapTimer/issues/7)
The Bluetooth stack is quite large and it seems we are running out of memory when we are using Bluetooth.
Unfortunately I can't say when to expect a fix for that. For now you'll have to disable Bluetooth.

Peschi90, 2020-04-15:
Memory could definetly be the problem. Sometimes if the Bluetooth connection lost because of range the chorus 32 stuck completely. I think you're right.

Thread 118 (2020-04-29):

Compiling on Platformio?

marcfon, 2020-04-29:
The ESP32LapTimer.ino file says to check the readme but the information there is quite sparse :)

Any pointers in the right direction are appreciated!

mottex, 2020-04-29:
I need as well more information - how to use platformio!

s00500, 2020-04-29:
If you are running platformIO from the cli you can specify the env via the -e option, in case the port selection fails you can specify the port in the platformio.ini file for each environment
See here:
https://docs.platformio.org/en/latest/projectconf/section_env_upload.html#upload-port

`pio run -e BOARD_OLD -t upload`

s00500, 2020-04-29:
Or use --upload-port on to specify in the run command as well :-)
Hope I could help

marcfon, 2020-04-29:
I managed to build and upload the project using platformio using the steps described in the first post.

I haven't yet managed to specify the env target (BOARD_DEFAULT / BOARD_TTGO_LORA / BOARD_OLD) from the GUI. So need to use the CLI for now to build and upload.

marcfon, 2020-04-30:
This is how to compile Chorus32 with Bluetooth support...

1. Uncomment `#define BluetoothEnabled` in `ESP32Laptimer.cpp`
2. Uncomment `#define USE_BLUETOOTH` in `HardwareConfig.h`
3. Add this line to platformio.ini `board_build.partitions = huge_app.csv`

Smeat, 2020-04-30:
I won't recommend using Bluetooth. See #117

marcfon, 2020-05-01:
I'm sure one day bluetooth will be stable and this information might become useful :)

Also wifi is broken on app on Android 10 so bluetooth might be the only alternative for some.

Smeat, 2020-05-01:
But as of now, if you are using Bluetooth, the timer might crash any time, so I'd deem this unusable in the current state.

As for the Android problem: I should have a working fix by tommorrow

marcfon, 2020-05-01:
@Smeat Thanks for pointing that out. And looking forward to beta testing the android version :)

Pamilias, 2022-10-04:
do we still need to change to BOARD_OLD in HardwareConfig.h?

Smeat, 2022-10-04:
Depends on which hardware your are using:

> Use `BOARD_OLD` if you are using [this wiring schema](https://github.com/AlessandroAU/Chorus32-ESP32LapTimer/blob/master/img/schematic2.png) and `BOARD_DEFAULT` if you're using the [PCB v2.2 wiring schema](https://github.com/AlessandroAU/Chorus32-ESP32LapTimer/blob/master/pcb/JyeSmith/PCBV2.2/Schematic-V2.2.png).

Thread 119 (2020-05-01):

Which build target matches the schematics?

marcfon, 2020-05-01:
I'm building a setup based on [this wiring schema](https://github.com/AlessandroAU/Chorus32-ESP32LapTimer/blob/master/img/schematic2.png).

Does this schema match the `BOARD_DEFAULT` or the `BOARD_OLD` build target?

Smeat, 2020-05-01:
BOARD_OLD.
BOARD_DEFAULT is the PCB from Jye: https://github.com/AlessandroAU/Chorus32-ESP32LapTimer/blob/master/pcb/JyeSmith/PCBV2.2/Schematic-V2.2.png

marcfon, 2020-05-02:
Thanks! Is there a change log kind of thing to see how what changed in BOARD_DEFAULT? For instance if you want rewire things to match the new board.

marcfon, 2020-05-02:
What is the purpose of the two separate oled connections from vcc and gnd on the v2.2 PCB?

Smeat, 2020-05-02:
> Thanks! Is there a change log kind of thing to see how what changed in BOARD_DEFAULT? For instance if you want rewire things to match the new board.

No just a different design for a PCB. Since most digital functions can be done by any pin, the assignment is quite arbitrary.
If you already have wired everything, there is not much reason to change that.

> What is the purpose of the two separate oled connections from vcc and gnd on the v2.2 PCB?

I think it is to accommodate for different pinouts with those OLED modules

marcfon, 2020-05-03:
After some trail and error I found the [v2.2 wiring easier](https://raw.githubusercontent.com/AlessandroAU/Chorus32-ESP32LapTimer/master/pcb/JyeSmith/PCBV2.2/Schematic-V2.2.png) to match with the **ESP32 Devkit v1** that I'm using. With the first wiring I used you need to translate the pinout (and I failed to do that successfully).

Thread 123 (2020-07-07):

PlatformIO (VSCode)

TechVic-1, 2020-07-07:
Move Platformio.ini and .gitignore out of ESP32LapTimer folder

Smeat, 2020-07-07:
If we move `platformio.ini` we break the build system ;)
What is the reason you want to move it?

TechVic-1, 2020-07-07:
NO you don't. This is the first repository that doesn't have the platformio.ini file in root folder. Check any repository that uses vscode and platformIO you will see. I want to move it because platformio doesn't like when it's not in root and using  GitHub Desktop then you can't use the built in functions like build and upload. Because platformio doesn't recognize it as an project

TechVic-1, 2020-07-07:
Example: [MarlinFirmware](https://github.com/MarlinFirmware/Marlin)

Smeat, 2020-07-07:
Without modification it'll break, because it won't find the `src` folder.
As this project also contains other stuff besides the firmware, I don't see any reason or benefit to move it to the root. Just seems like more clutter.
It also prevents us from adding other firmwares, which might be the case in the near future. Not clue if there is a clean way to do it, since my pio knowledge is rather limited.

Besides that I am still missing the point. If your program won't recognize the project, can't you just select "ESP32LapTimer" as the root? (Sorry I have absolutely no clue about the software you are using)
I think there were some people using it, but the documentation is still TODO.

If you can make a compelling argument why this is beneficial, feel free to submit a pr.
But "others do it" isn't a valid argument. A quick search even showed, that there a bunch of projects, which don't have the platformio.ini in their root.

TechVic-1, 2020-07-08:
Yes Okay you need to add the lines in platformio.ini `[platformio]
src_dir      = ESP32LapTimer`
Check out FireFly-Nano platformio.ini file, here you just uncomment which board you have and hitt build or upload.
I just wanted to help make it easier for people to compile it

TechVic-1, 2020-07-08:
[GitHub desktop](https://desktop.github.com/)

Smeat, 2020-07-08:
> I just wanted to help make it easier for people to compile it

Nothing wrong with that :) I am always happy to get a different perspective, since my knowledge with the GUI-tools is rather limited.
I think in this case it is just a problem of the missing documentation.

Having to edit the platformio.ini is something I didn't do by design, since editing the config files of the build system, just to select a different target, is definitely the wrong approach and runtime configuration should always be preferred.

s00500, 2020-08-24:
to select the board environments should be used

Thread 124 (2020-07-16):

INA219 incorrect reading

marcfon, 2020-07-16:
The reading from my INA219 off by about 0.3v compared to when I read voltage with a multimeter across the battery + and -.

I've got the VIN- connected to + terminal of the battery [according to this schema](https://github.com/AlessandroAU/Chorus32-ESP32LapTimer/blob/master/img/schematic2.png).

Did a miss a wire or setting somewhere?

Smeat, 2020-07-21:
Sorry, I don't have an INA219, so my ability to help is limited.
But it seems the wiring diagram is missing something, as VIN- is unconnected. You better use [Jye's PCB](https://raw.githubusercontent.com/AlessandroAU/Chorus32-ESP32LapTimer/master/pcb/JyeSmith/PCBV2.2/Schematic-V2.2.png)  as a reference.
Also make sure you are measuring as close to the INA219 as possible.

marcfon, 2020-07-21:
Thanks for thinking along Smeat. You don't have to have VIN- connect if you're just monitoring voltage. If you also want to measure current then you do so it depends. I fiddled around a bit more but couldn't find the cause. Not a dealbreaker but curious if more people ran into this.

Thread 125 (2021-05-16):

Not connecting on iOS

kyleallen02, 2021-05-16:
I can’t locate the lap timer on my iOS device(iPhone 6S Plus and IPad Pro).

Does not show up in Bluetooth at all, and when I try connect via WiFi it crashes the app or I get an API version error (node(1 has API version: 4 and node(0 has API version: 4)

Am I doing something wrong? I do see it on my MacBook under Bluetooth but not on any mobile devices.

Thread 127 (2022-06-04):

Compilation error 'touch_pad_filter_start' was not declared in this scope

arnaudmorin, 2022-06-04:
Hello,

I cloned the code
Entered the `ESP32LapTimer` folder
Then trying to upload:

```bash
pio run -e BOARD_OLD -t upload

src/Buttons.cpp: In function 'void newButtonSetup()':
src/Buttons.cpp:63:3: error: 'touch_pad_filter_start' was not declared in this scope
   touch_pad_filter_start(BUTTON1);
   ^~~~~~~~~~~~~~~~~~~~~~
src/Buttons.cpp:63:3: note: suggested alternative: 'touch_trigger_src_t'
Compiling .pio/build/BOARD_OLD/src/HardwareConfig.cpp.o
   touch_pad_filter_start(BUTTON1);
   ^~~~~~~~~~~~~~~~~~~~~~
   touch_trigger_src_t
src/Buttons.cpp:64:3: error: 'touch_pad_set_filter_period' was not declared in this scope
   touch_pad_set_filter_period(BUTTON1);
   ^~~~~~~~~~~~~~~~~~~~~~~~~~~
Compiling .pio/build/BOARD_OLD/src/Laptime.cpp.o
*** [.pio/build/BOARD_OLD/src/Buttons.cpp.o] Error 1

```

arnaudmorin, 2022-06-04:
After removing the faulty buttons.cpp code:

```bash
$ git diff

diff --git a/ESP32LapTimer/src/Buttons.cpp b/ESP32LapTimer/src/Buttons.cpp
index 22621a7..db3205d 100644
--- a/ESP32LapTimer/src/Buttons.cpp
+++ b/ESP32LapTimer/src/Buttons.cpp
@@ -59,11 +59,6 @@ void newButtonSetup() {
 #ifdef USE_NORMAL_BUTTONS
   pinMode(BUTTON1, INPUT_PULLUP);
   pinMode(BUTTON2, INPUT_PULLUP);
-#else
-  touch_pad_filter_start(BUTTON1);
-  touch_pad_set_filter_period(BUTTON1);
-  touch_pad_filter_start(BUTTON2);
-  touch_pad_set_filter_period(BUTTON2);
 #endif
 }

```

it compiles, but finally error because of too big firmware:

```bash
Error: The program size (1448665 bytes) is greater than maximum allowed (1310720 bytes)
```
What should I do?

Z1gun, 2022-08-01:
I have pio 6.1.3 and got same issues on Windows and Linux machine. What the correct solution of Buttons.cpp compiler error?

Smeat, 2022-08-01:
I was using pip. Sorry, forgot to add that. Fixed it in my previous post.

> What the correct solution of Buttons.cpp compiler error?
That is the weird part: I don't get any error on my machine.

But I was able to reproduce both in a VM. It is probably some library update. I'll look into it in the following days.

Smeat, 2022-08-20:
This should be fixed with #130. If not feel free to reopen.

Closed 2022-08-20.

Thread 129 (2022-08-01):

The program size (1569757 bytes) is greater than maximum allowed (1310720 bytes)

Z1gun, 2022-08-01:
Build in VScode with platformio extension. In Buttons.cpp change:
from
#ifdef USE_NORMAL_BUTTONS
to
#ifndef USE_NORMAL_BUTTONS

Another, got issue  #127

Smeat, 2022-08-01:
Seems to be the same Issue as #127, so I think we should continue the discussion there.

Closed 2022-08-01.

Thread 136 (2023-09-30):

FPV Trackside

lesharodin, 2023-09-30:
Does anyone have succesfully connect chorus32 to fpv trackside?
There is chorus32, but I have no luck to make it work.
With android chorus app it works well
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
