AlessandroAU/Chorus32-ESP32LapTimer/pcb/smeat/esp32-wroom-timer-v1/esp32-wroom-timer.pdf

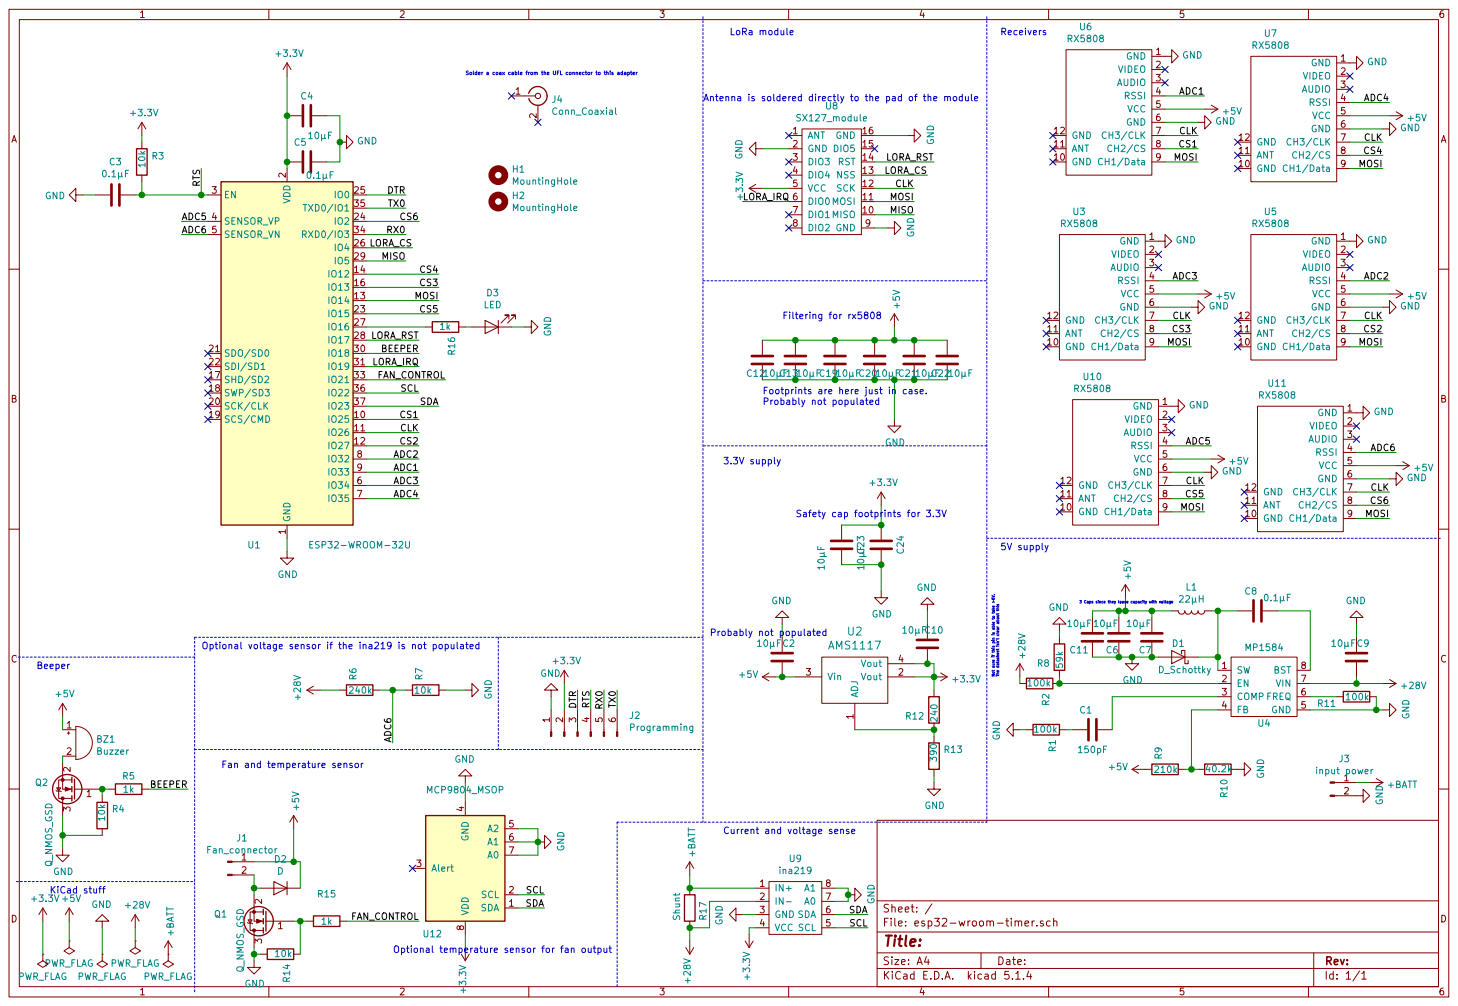
[picture p18: page 1]

Solder a coax cable from the UFL connector to this adapter

Antenna is soldered directly to the pad of the module

100k GND

Footprints are here just in case.
Probably not populated

2 SCK/CLK 20 SDO/SD0 21 SDI/SD1 22

3 Caps since they loose capacity with voltage Current and voltage sense

Optional voltage sensor if the ina219 is not populated

Optional temperature sensor for fan output
