AlessandroAU/Chorus32-ESP32LapTimer/pcb/smeat/esp32-wroom-timer-v1/esp32-wroom-timer.kicad_pcb

## KiCad design pcb/smeat/esp32-wroom-timer-v1/esp32-wroom-timer.kicad_pcb (2020-05-23)

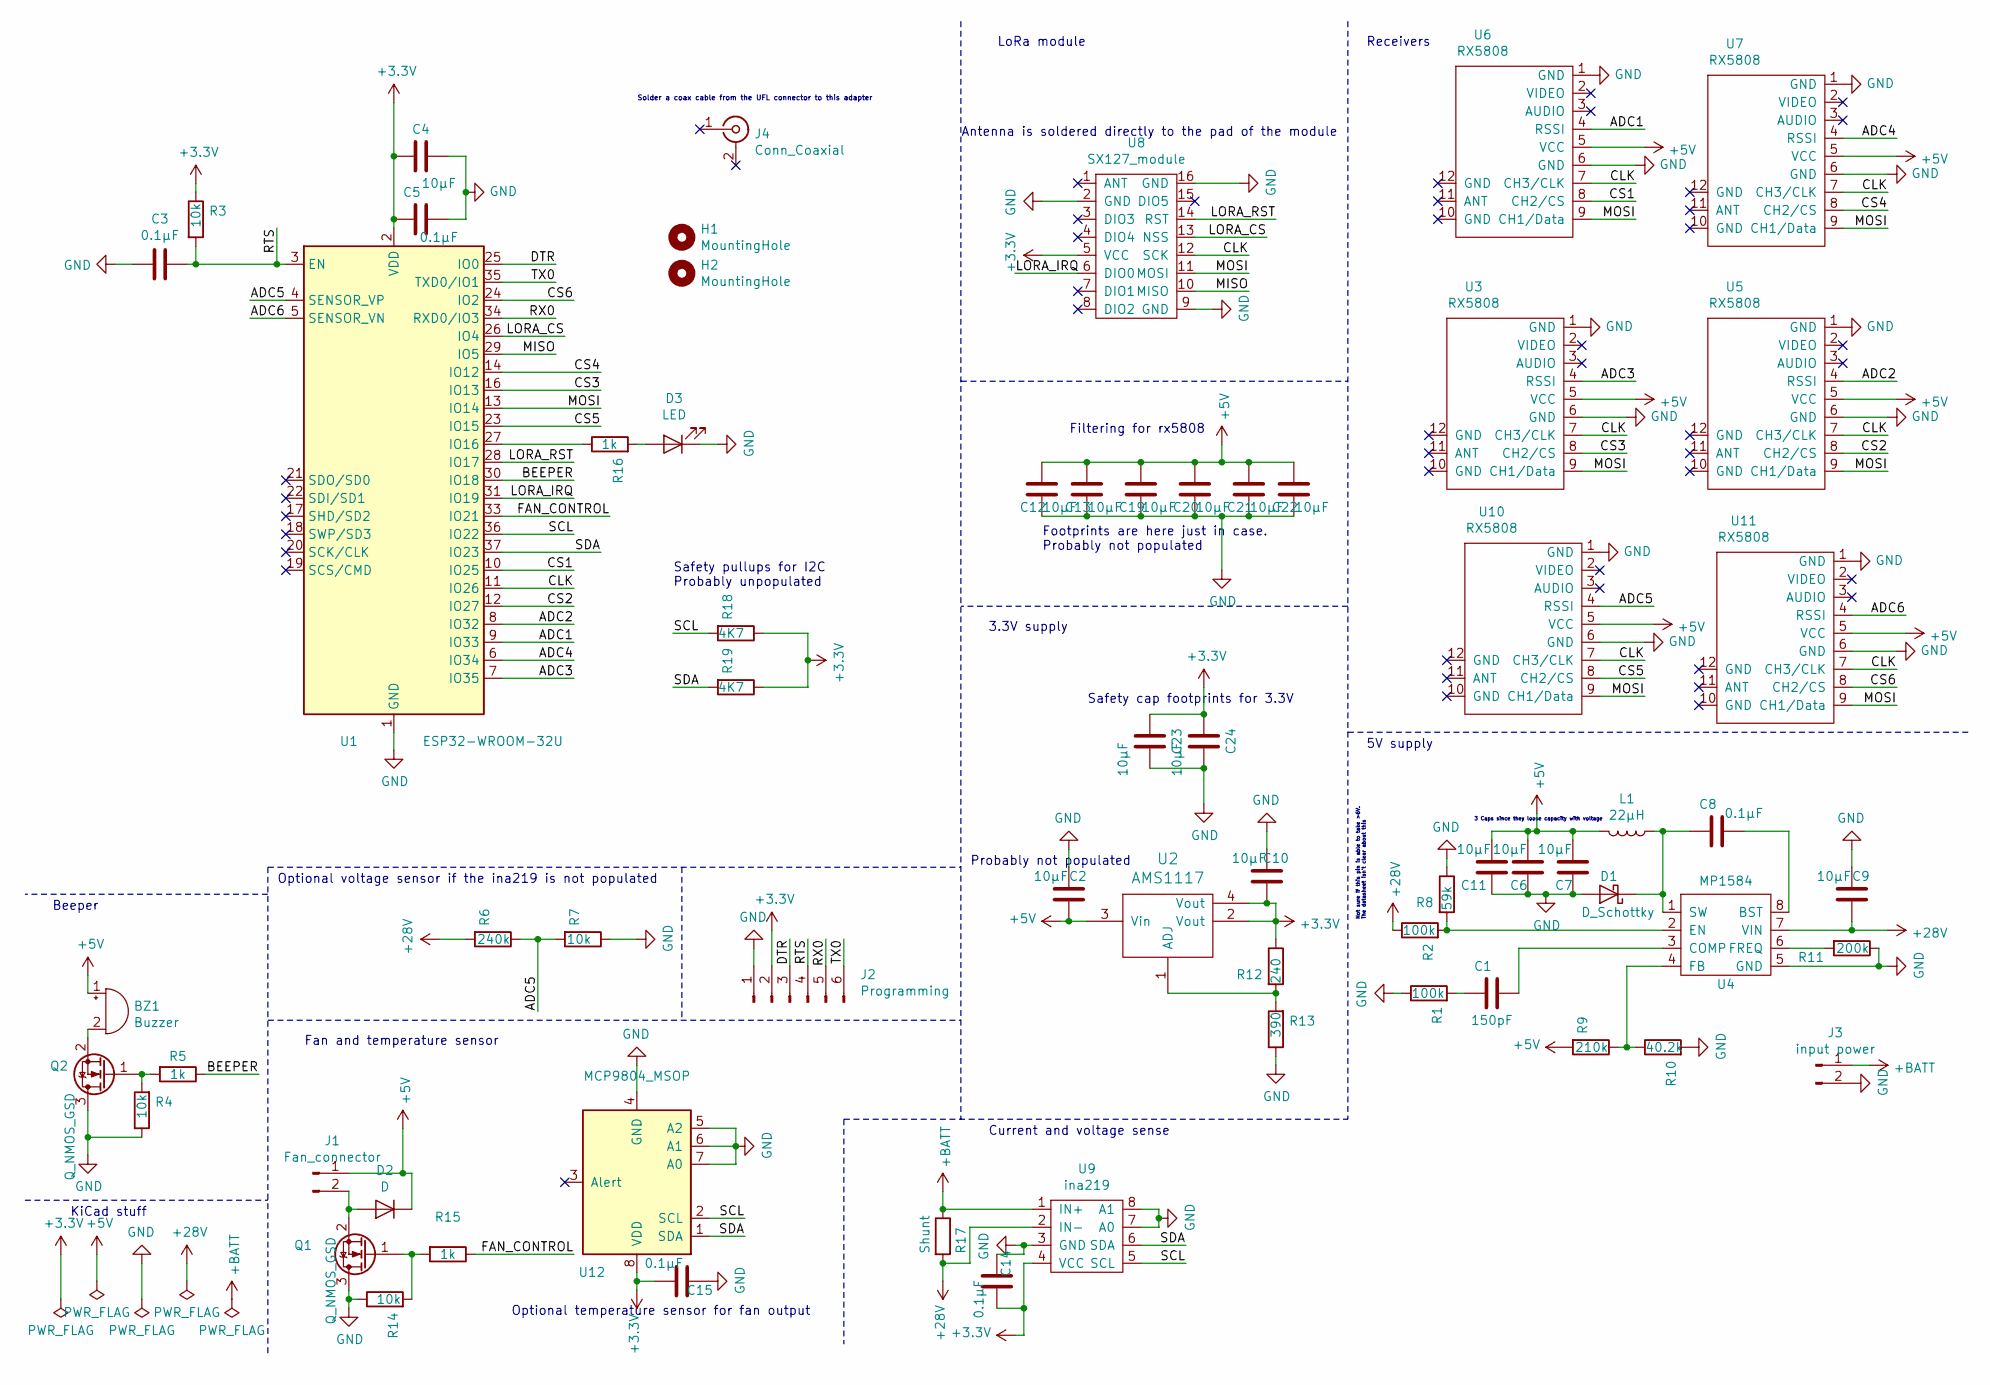
[picture p19: schematic esp32-wroom-timer.sch]

Parts:
BZ1: Buzzer; MagneticBuzzer_Kingstate_KCG0601
C1: 150pF; C_0603_1608Metric
C2, C4, C6, C7, C9, C10, C11, C12, C13, C19, C20, C21, C22, C23, C24: 10µF; C_0805_2012Metric
C3, C5, C8, C14, C15: 0.1µF; C_0603_1608Metric
D1: D_Schottky; D_SMA
D2: D; D_SMA
D3: LED; LED_0805_2012Metric
H1, H2: MountingHole; MountingHole_3.2mm_M3
J1: Fan_connector; PinHeader_2x01_P2.00mm_Vertical_SMD
J2: Programming; PinHeader_1x06_P2.00mm_Vertical
J3: input power; SolderWirePad_1x02_P7.62mm_Drill2.5mm
J4: Conn_Coaxial; SMA_Amphenol_132289_EdgeMount
L1: 22µH; L_12x12mm_H6mm
Q1, Q2: Q_NMOS_GSD; SOT-23
R1, R2: 100k; R_0805_2012Metric
R3, R4, R7, R14: 10k; R_0805_2012Metric
R5, R15, R16: 1k; R_0805_2012Metric
R6: 240k; R_0805_2012Metric
R8: 59k; R_0805_2012Metric
R9: 210k; R_0805_2012Metric
R10: 40.2k; R_0805_2012Metric
R11: 200k; R_0805_2012Metric
R12: 240; R_0805_2012Metric
R13: 390; R_0805_2012Metric
R17: Shunt; R_2512_6332Metric
R18, R19: 4K7; R_0805_2012Metric
U1: ESP32-WROOM-32U
U2: AMS1117; SOT-223
U3, U5, U6, U7, U10, U11: RX5808; rx5808
U4: MP1584; SOIC-8_3.9x4.9mm_P1.27mm
U8: SX127_module; sx1276_module
U9: ina219; SOT-23-8
U12: MCP9804_MSOP; MSOP-8_3x3mm_P0.65mm

Connections:
+3V3: C4.2, C5.2, C10.1, C14.1, C15.1, C23.2, C24.2, J2.2, R3.1, R12.1, R18.1, R19.1, U1.2 (VDD), U2.2 (Vout), U2.4 (Vout), U8.5 (VCC), U9.4 (VCC), U12.8 (VDD)
+5V: BZ1.1 (-), C2.1, C6.2, C7.2, C11.2, C12.1, C13.1, C19.1, C20.1, C21.1, C22.1, D2.1 (K), J1.1, L1.2, R9.2, U2.3 (Vin), U3.5 (VCC), U5.5 (VCC), U6.5 (VCC), U7.5 (VCC), U10.5 (VCC), U11.5 (VCC)
+28V: C9.1, R2.1, R6.2, R17.2, U4.7 (VIN), U9.2 (IN-)
+BATT: J3.1, R17.1, U9.1 (IN+)
/ADC1: U1.9 (IO33), U6.4 (RSSI)
/ADC2: U1.8 (IO32), U5.4 (RSSI)
/ADC3: U1.7 (IO35), U3.4 (RSSI)
/ADC4: U1.6 (IO34), U7.4 (RSSI)
/ADC5: R6.1, R7.2, U1.4 (SENSOR_VP), U10.4 (RSSI)
/ADC6: U1.5 (SENSOR_VN), U11.4 (RSSI)
/BEEPER: R5.1, U1.30 (IO18)
/CLK: U1.11 (IO26), U3.7 (CH3/CLK), U5.7 (CH3/CLK), U6.7 (CH3/CLK), U7.7 (CH3/CLK), U8.12 (SCK), U10.7 (CH3/CLK), U11.7 (CH3/CLK)
/CS1: U1.10 (IO25), U6.8 (CH2/CS)
/CS2: U1.12 (IO27), U5.8 (CH2/CS)
/CS3: U1.16 (IO13), U3.8 (CH2/CS)
/CS4: U1.14 (IO12), U7.8 (CH2/CS)
/CS5: U1.23 (IO15), U10.8 (CH2/CS)
/CS6: U1.24 (IO2), U11.8 (CH2/CS)
/DTR: J2.3, U1.25 (IO0)
/FAN_CONTROL: R15.1, U1.33 (IO21)
/LORA_CS: U1.26 (IO4), U8.13 (NSS)
/LORA_IRQ: U1.31 (IO19), U8.6 (DIO0)
/LORA_RST: U1.28 (IO17), U8.14 (RST)
/MISO: U1.29 (IO5), U8.10 (MISO)
/MOSI: U1.13 (IO14), U3.9 (CH1/Data), U5.9 (CH1/Data), U6.9 (CH1/Data), U7.9 (CH1/Data), U8.11 (MOSI), U10.9 (CH1/Data), U11.9 (CH1/Data)
/RTS: C3.1, J2.4, R3.2, U1.3 (EN)
/RX0: J2.5, U1.34 (RXD0/IO3)
/SCL: R18.2, U1.36 (IO22), U9.5 (SCL), U12.2 (SCL)
/SDA: R19.2, U1.37 (IO23), U9.6 (SDA), U12.1 (SDA)
/TX0: J2.6, U1.35 (TXD0/IO1)
GND: C2.2, C3.2, C4.1, C5.1, C6.1, C7.1, C9.2, C10.2, C11.1, C12.2, C13.2, C14.2, C15.2, C19.2, C20.2, C21.2, C22.2, C23.1, C24.1, D1.2 (A), D3.1 (K), J2.1, J3.2, Q1.3 (D), Q2.3 (D), R1.1, R4.1, R7.1, R8.1, R10.2, R11.1, R13.1, R14.1, U1.1 (GND), U1.15 (GND), U1.38 (GND), U3.1 (GND), U3.6 (GND), U4.5 (GND), U5.1 (GND), U5.6 (GND), U6.1 (GND), U6.6 (GND), U7.1 (GND), U7.6 (GND), U8.2 (GND), U8.9 (GND), U8.16 (GND), U9.3 (GND), U9.7 (A0), U9.8 (A1), U10.1 (GND), U10.6 (GND), U11.1 (GND), U11.6 (GND), U12.4 (GND), U12.5 (A2), U12.6 (A1), U12.7 (A0)
unnamed: BZ1.2 (+), Q2.2 (S)
unnamed: C1.1, U4.3 (COMP)
unnamed: C1.2, R1.2
unnamed: C8.1, U4.8 (BST)
unnamed: C8.2, D1.1 (K), L1.1, U4.1 (SW)
unnamed: D2.2 (A), J1.2, Q1.2 (S)
unnamed: D3.2 (A), R16.2
unnamed: Q1.1 (G), R14.2, R15.2
unnamed: Q2.1 (G), R4.2, R5.2
unnamed: R2.2, R8.2, U4.2 (EN)
unnamed: R9.1, R10.1, U4.4 (FB)
unnamed: R11.2, U4.6 (FREQ)
unnamed: R12.2, R13.2, U2.1 (ADJ)
unnamed: R16.1, U1.27 (IO16)

Notes on the sheet:
Antenna is soldered directly to the pad of the module
Filtering for rx5808
Not sure if this pin is able to take >6V. The datasheet isn't clear about this
3 Caps since they loose capacity with voltage
Probably not populated
Footprints are here just in case. Probably not populated
Optional temperature sensor for fan output
KiCad stuff
5V supply
Receivers
Safety cap footprints for 3.3V
3.3V supply
Current and voltage sense
Fan and temperature sensor
Beeper
LoRa module
Optional voltage sensor if the ina219 is not populated
Solder a coax cable from the UFL connector to this adapter
Safety pullups for I2C Probably unpopulated

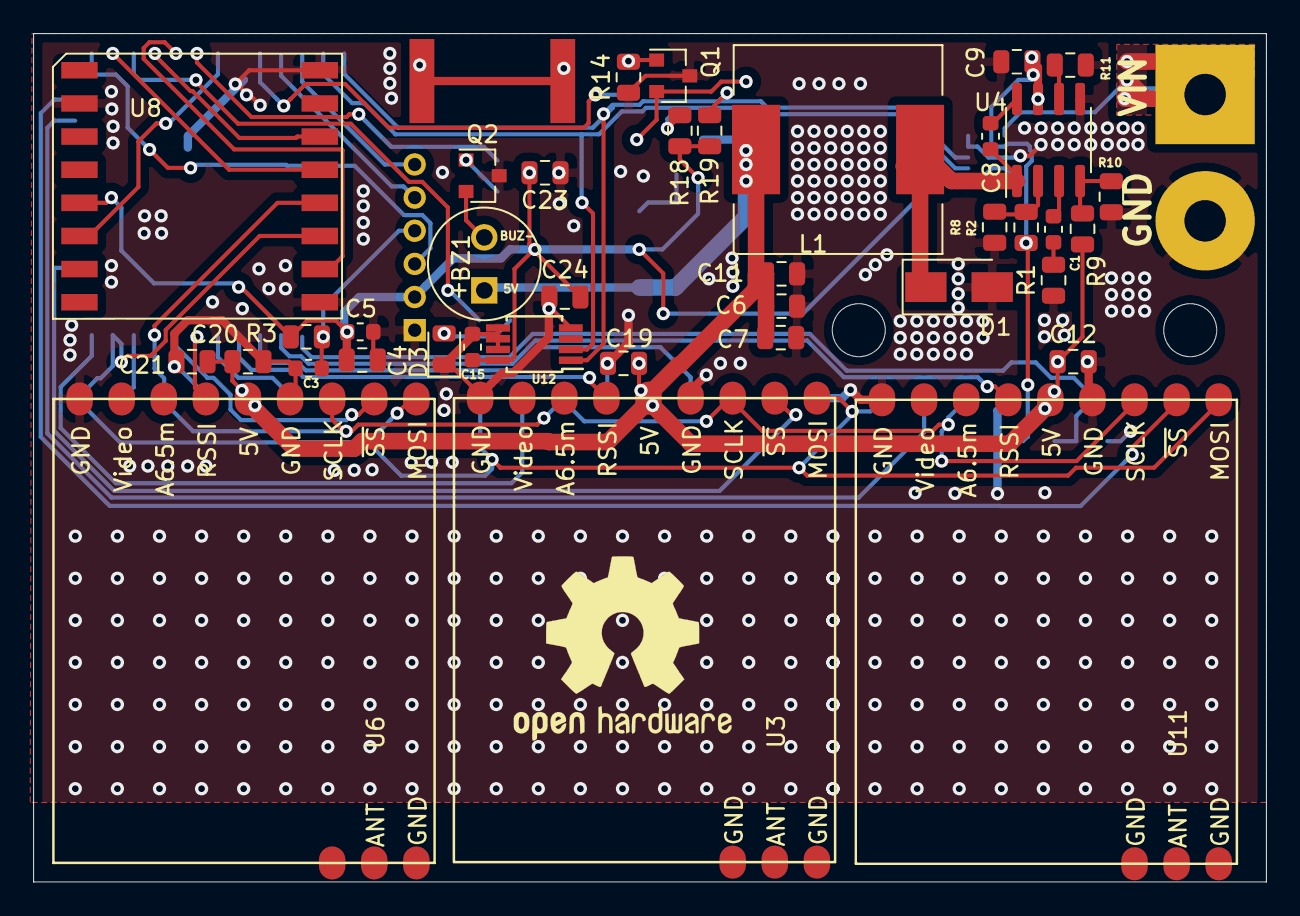
[picture p20: board esp32-wroom-timer.kicad_pcb from above]

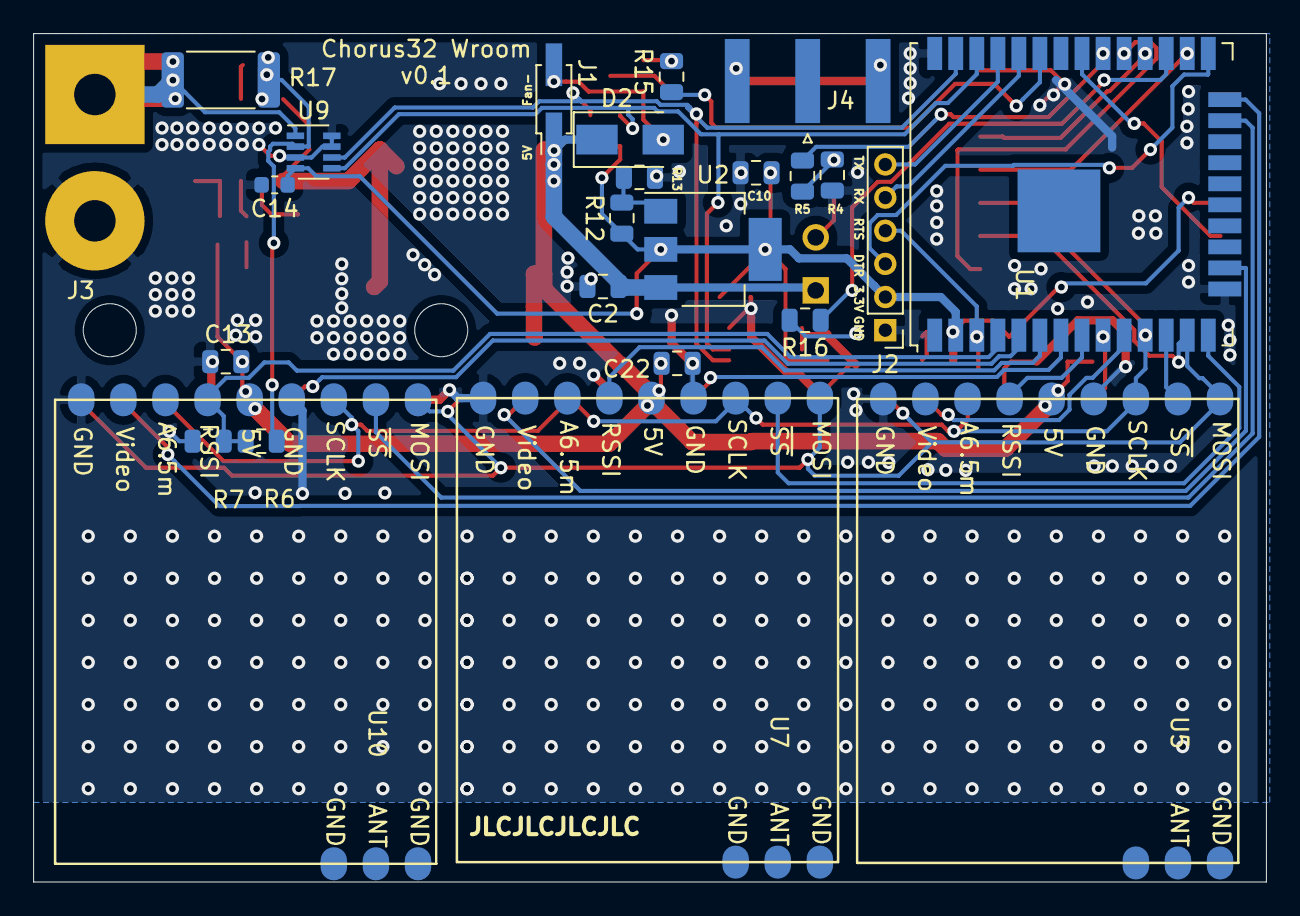
[picture p21: board esp32-wroom-timer.kicad_pcb from below]

Board: 2 copper layers, 74.4 x 51.2 mm, 65 parts (25 on the bottom side), 45 nets.
