AlessandroAU/Chorus32-ESP32LapTimer/ESP32LapTimer/src/Screensaver.h

/*
 * This file is part of Chorus32-ESP32LapTimer 
 * (see https://github.com/AlessandroAU/Chorus32-ESP32LapTimer).
 *
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
 * You should have received a copy of the GNU General Public License
 * along with this program. If not, see <http://www.gnu.org/licenses/>.
 */
#ifndef SCREENSAVER_h
#define SCREENSAVER_h
//------------------------------------------------------------------------------
// File generated by LCD Assistant
// http://en.radzio.dxp.pl/bitmap_converter/
// How to;
// https://github.com/ThingPulse/esp8266-oled-ssd1306/issues/53#issuecomment-354174183
//------------------------------------------------------------------------------

const uint8_t ChorusLaptimerLogo_Screensaver[] PROGMEM = {
//const unsigned char ChorusLaptimerLogo_Screensaver [] = {
  0x00, 0x00, 0x00, 0x00, 0x00, 0x00, 0x00, 0x00, 0x00, 0x00, 0x00, 0x00, 
  0x00, 0x00, 0x00, 0x00, 0x00, 0x00, 0x00, 0x00, 0x00, 0x00, 0x00, 0x00, 
  0x00, 0x18, 0x00, 0x00, 0x00, 0x00, 0x00, 0x00, 0x00, 0xF8, 0x00, 0x00, 
  0x00, 0x00, 0x00, 0x00, 0x00, 0xFC, 0x07, 0x00, 0x00, 0x00, 0x00, 0x00, 
  0x00, 0xE0, 0x3F, 0x00, 0x00, 0x00, 0x00, 0x00, 0x00, 0x80, 0xFF, 0x01, 
  0x00, 0x00, 0x00, 0x00, 0x00, 0x1C, 0xFC, 0x1F, 0x00, 0x00, 0x00, 0x00, 
  0x00, 0xFE, 0xE0, 0xFF, 0x00, 0x00, 0x00, 0x00, 0x00, 0xFF, 0x07, 0xFF, 
  0x0F, 0x00, 0x00, 0x00, 0x80, 0xFF, 0x3F, 0xF8, 0x7F, 0x00, 0x00, 0x00, 
  0x80, 0xFF, 0x3F, 0xC1, 0xFF, 0x03, 0x00, 0x00, 0xC0, 0xFF, 0x1F, 0x08, 
  0xFE, 0x1F, 0x00, 0x00, 0xC0, 0xFF, 0x0F, 0x40, 0xF0, 0xFF, 0x00, 0x00, 
  0xE0, 0xFF, 0x0F, 0x00, 0x80, 0xFF, 0x07, 0x00, 0xF0, 0xFF, 0x07, 0x00, 
  0x1C, 0xFC, 0x7F, 0x00, 0xF0, 0xFF, 0x03, 0x00, 0x7C, 0xE0, 0xFF, 0x03, 
  0xF0, 0xFF, 0x01, 0x00, 0xFE, 0x87, 0xFF, 0x3F, 0xC0, 0xFF, 0x01, 0x00, 
  0xFF, 0x1F, 0xFC, 0x3F, 0x00, 0xFE, 0x00, 0x80, 0xFF, 0xFF, 0xE0, 0x1F, 
  0x00, 0xF0, 0x00, 0xC0, 0xFF, 0xFF, 0x01, 0x1F, 0x00, 0x00, 0x00, 0xC0, 
  0xFF, 0x7F, 0x00, 0x08, 0x04, 0x80, 0x01, 0xE0, 0xFF, 0x3F, 0x00, 0x00, 
  0x04, 0xC0, 0x0F, 0xF0, 0xFF, 0x1F, 0x00, 0x00, 0x04, 0xC0, 0x7F, 0xF0, 
  0xFF, 0x0F, 0x00, 0x00, 0x04, 0xC0, 0xFF, 0xF9, 0xFF, 0x07, 0x00, 0x00, 
  0x04, 0xE0, 0xFF, 0xF7, 0xFF, 0x03, 0x00, 0x00, 0x04, 0xE0, 0xFF, 0x83, 
  0xFF, 0x01, 0x00, 0x00, 0x04, 0xE0, 0xFF, 0x03, 0xFC, 0x00, 0x00, 0x00, 
  0x00, 0xE0, 0xFF, 0x01, 0xF0, 0x00, 0x00, 0x00, 0x20, 0xE0, 0xFF, 0x01, 
  0x00, 0x00, 0x00, 0x00, 0x00, 0xE0, 0xFF, 0x00, 0x00, 0x00, 0x00, 0x00, 
  0x00, 0xE4, 0xFF, 0x00, 0x00, 0x00, 0x00, 0x00, 0x00, 0xE0, 0xFF, 0x00, 
  0x90, 0x03, 0x00, 0x00, 0x00, 0x00, 0xFF, 0x00, 0xC0, 0x07, 0x00, 0x00, 
  0x80, 0x03, 0xFC, 0x00, 0xC8, 0x07, 0x00, 0x00, 0x80, 0x3F, 0x70, 0x00, 
  0xE0, 0x07, 0x00, 0x00, 0x80, 0xFF, 0x87, 0x00, 0xF4, 0x07, 0x00, 0x00, 
  0x80, 0xFF, 0x47, 0x00, 0xF0, 0x07, 0x00, 0x00, 0x00, 0xFC, 0x07, 0x00, 
  0xB0, 0x07, 0x00, 0x00, 0x00, 0xE0, 0x07, 0x80, 0xC2, 0x07, 0x00, 0x00, 
  0x00, 0x00, 0x03, 0x80, 0xF3, 0x07, 0x00, 0x00, 0x10, 0x00, 0x0C, 0xC0, 
  0xFF, 0x07, 0x00, 0x00, 0x00, 0x00, 0x7E, 0xC0, 0xFF, 0x03, 0x00, 0x00, 
  0x00, 0x00, 0xFE, 0xE3, 0xFF, 0x03, 0x00, 0x00, 0x04, 0x00, 0xFF, 0xFF, 
  0xFF, 0x03, 0x00, 0x00, 0x00, 0x00, 0xFF, 0x0F, 0xFF, 0x01, 0x00, 0x00, 
  0x04, 0x80, 0xFF, 0x07, 0xF0, 0x00, 0x00, 0x00, 0x20, 0xC0, 0xFF, 0x07, 
  0xC0, 0x00, 0x00, 0x00, 0x00, 0xE0, 0xFF, 0x03, 0x00, 0x00, 0x00, 0x00, 
  0x00, 0xF0, 0xFF, 0x01, 0x40, 0x00, 0x00, 0x00, 0x00, 0xC0, 0xFF, 0x00, 
  0x00, 0x3E, 0x00, 0x00, 0x00, 0x00, 0x7F, 0x00, 0x00, 0x7F, 0xF8, 0x0F, 
  0x00, 0x00, 0x30, 0x00, 0x90, 0xF3, 0xF8, 0x0F, 0x00, 0x00, 0x40, 0x00, 
  0x80, 0xC1, 0x00, 0x0C, 0x00, 0x00, 0x00, 0x02, 0x84, 0xC1, 0x00, 0x0C, 
  0x00, 0x00, 0x00, 0x10, 0x80, 0xE3, 0x00, 0x0C, 0x00, 0x00, 0x00, 0x80, 
  0x80, 0x73, 0x00, 0x0C, 0x00, 0x00, 0x00, 0x00, 0x00, 0x23, 0x00, 0x00, 
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
#endif
