AlessandroAU/Chorus32-ESP32LapTimer/ESP32LapTimer/ESP32LapTimer.ino

/*
We moved our build system to platformio. Take a look at the readme to see on how to use the new system.

You are still able to use the Arduino IDE as you used to, but you won't be able to see the any other files. If you want to change the configuration you need to use an external editor.
*/
