AlessandroAU/Chorus32-ESP32LapTimer/(commit log)

2018-11-23 Update ESP32LapTimer.ino.esp32.bin
    Updated Precompiled Binary
2018-12-07 Disabled BLE by default
    Added #ifdef option #define BluetoothEnabled to enable bluetooth, otherwise bluetooth is now disabled by default. Appears to fix issues with wifi drop caused by bluetooth.
    [Bluetooth.ino, Comms.ino, ESP32LapTimer.ino, UDP.ino]
2019-02-08 Add diagram
    added wiring diagram and code template for eventual eeprom settings storage
2019-02-08 updated some figures
    [laptimer comparison.xlsx]
2019-02-23 adds ina219 voltage monitoring
    This pull frees the current analog pin used for voltage monitoring for another rx5808.
2019-02-23 adds oled
    Initial oled implementation.
    TODO - remove oledUpdate() from main loop and add to a timer for updating once a second.
2019-02-24 a little organisation
    [laptimer comparison.xlsx]
2019-02-24 fixes oled with another #ifdef AlessandroDevBoard
    [HardwareConfig.h, OLED.ino]
2019-02-24 initial commit, not working
    [Comms.ino, ESP32LapTimer.ino, HardwareConfig.h, settings_eeprom.h, settings_eeprom.ino]
2019-02-24 New filter Implimentation
2019-02-28 Updated schematic
2019-03-01 pcb files
2019-03-02 fix spi defines
2019-03-02 ASYNC webserver + Make ADC reads non-blocking
2019-03-02 revert to old webserver
    [ESP32LapTimer.ino, Filter.h, HardwareConfig.h, OLED.ino, WebServer.ino, settings_eeprom.h]
2019-03-02 adds timer
2019-03-02 adds ina219 read on 1s timer
2019-03-02 adds timer to oled update
2019-03-03 Revert "adds 6 rx to oled"
    This reverts commit d66650e8dc6503e8669c6771d1577609d937a84e.
    [OLED.ino]
2019-03-03 OLED + EEPROM + WEBSEVER
    Lots of changes and fixes,
    Main change is webserver variable configuration works and will save to eeprom.
    [ADC.h, ADC.ino, Bluetooth.h, Comms.ino, ESP32LapTimer.ino, Filter.h, HardwareConfig.h]
2019-03-03 Update HardwareConfig.h
    Fixed default #define
    [HardwareConfig.h]
2019-03-05 Fixed bug causing crash during race
    [ADC.ino, ESP32LapTimer.ino, UDP.h, UDP.ino, Utils.h, WebServer.ino]
2019-03-06 Added 6ch Schematic
2019-03-07 buttons
    ...because why not?
2019-03-07 Fixed critical bug with timer cal for >4 pilots
    [Comms.ino, ESP32LapTimer.ino, UDP.ino]
2019-03-07 Forgot to renenable websever
    Forgot to comment out some code while I was debugging another issue
    [ESP32LapTimer.ino]
2019-03-08 change buttons to use timer
2019-03-08 remove serial print noise
    [ADC.ino]
2019-03-10 Fixed multiple readout bug
    [ADC.ino, Comms.ino, HardwareConfig.ino, UDP.h, UDP.ino]
2019-03-12 fixed some errors, not working yet
    [WebServer.ino]
2019-03-12 Fixed json creation and loading
    [WebServer.ino]
2019-03-13 Fixed showing incorrect band and channel data on website
    [WebServer.ino]
2019-03-20 Fixed absolute timing for LiveTime
    LiveTime is looking for time since race start, previous code was giving time since Chorus booted up.
    [Comms.ino]
2019-03-22 PCB V2 open for comments
2019-03-23 adds multiple oled displays for stats, debug info
    Pressing button 1 cycles through the displays.
2019-03-23 Added power down/up options
2019-03-23 remove power mangement (seem to cause isses)
2019-03-31 Added video walkthrough for Chorus32 Installation
    Created a video showing the installation/setup process of Chorus32 on an ESP32 using Arduino IDE, with links included in the description to all software and libraries required for the process.
2019-04-01 Revert "Added video walkthrough for Chorus32 Installation via Arduino IDE"
2019-04-01 Revert "Revert "Added video walkthrough for Chorus32 Installation via Arduino IDE""
2019-04-04 Resolved RSSI<50 artifact
    Added logic to display an RSSI bar for 50 whenever the RSSI drops below 50, resolving the graphic artifact on the OLED display.
    [OLED.ino]
2019-04-06 Add missing ifdef to WebServer code.
    Add missing ifdef block to disable OledUpdate() inside WebServer code.
    Fix compilation errors when oled is disabled in configuration.
    [WebServer.ino]
2019-04-07 adds rx module calibration
2019-04-07 use ADCvalues[] with Filter_10HZ
    Replaces multiple ADC reads with filtered reads,
    [ADC.h, ADC.ino, Calibration.h]
2019-04-08 constrain() rawRSSI to min and max calibration values
2019-04-10 Added CalibrateRSSI and eeprom settings to web interface
2019-04-10 Added Airplane Mode Settings screen
    Added a 4th screen which contains airplane mode settings. Press button 1 until you arrive at screen 4, then press button 2 to toggle Airplane mode on/off. This results in a roughly 10% power savings if you're using an external module or hard-wired with a USB cable.
2019-04-11 Added calibrate RSSI and Eeprom values to index.html
2019-04-11 Added RX Settings screens
    Added screens dynamically based on the number of RX to be able to view and eventually change RX settings using the buttons.
2019-04-11 Attempt setting rx1 to B7
    A function is in place when Button 2 is pressed on ANY of the RX settings screens, which attempts to set RX1 to B7. It appears to briefly work, but does not save the settings, and it gets set right back to what it was before.
2019-04-11 Working frequency changes from OLED
    Fixed the issues with changing frequencies from the OLED.
    [OLED.ino, RX5808.ino]
2019-04-15 Button refactor and OLED screen navigation (#60)
    * Buttons and beeps
    New button presses, new screen navigation, new beep types. Need to clean up old button stuff.
    * Buttons.ino refactor
    Cleaned up old code and added additional comments for clarity.
    * Fixed typo
    [Beeper.h, Buttons.ino, ESP32LapTimer.ino, HardwareConfig.h, OLED.ino]
2019-05-19 Fix compilation on case sensitive systems. (#62)
    [Comms.ino]
2019-06-19 Allow the use of normal input buttons. (#64)
    Thanks :)
2019-06-19 Implement threshold setup (#66)
    * Implement threshold setup.
    * Fix array index.
    [ADC.h, ADC.ino, Comms.h, Comms.ino, ESP32LapTimer.ino]
2019-06-19 Skip ADC calibration for voltage monitor pin. (#63)
    [ADC.ino]
2019-06-25 Characterize adc to fight the non-linearity (#65)
2019-07-07 Some cleanup in ADC. (#67)
    Mainly removing unused variables and moving some from the header to the source file.
2019-07-07 Move .ino files to .cpp (#69)
    * Move ADC, eeprom, laptime and Calibration to cpp
    * Move HardwareConfig, Timer and UDP to cpp
    * Move RX5808 and Buttons to cpp.
    * Move comms, OLED and Bluetooth to cpp.
    * Move WebServer to cpp.
2019-07-07 Allow remapping of SPI pins. (#70)
    VSPI and HSPI don't really differ, as they are just names for spi2 and spi3.
    The object "SPI" is actually always VSPI, so the setting didn't do anything.
    [HardwareConfig.h, RX5808.cpp, config_default.h, config_ttgo_lora_v1.h]
2019-07-07 PCB-V2.1 (#53)
    https://easyeda.com/jyesmith/alessandroau-chorus32-esp32laptimer_v2-1
2019-07-08 Fix adc reading. (#77)
    [ADC.cpp]
2019-07-08 Fix all compiler warnings. (#79)
    [ADC.cpp, Comms.cpp, RX5808.cpp, Serial.h, Timer.cpp, Timer.h, WebServer.cpp]
2019-07-14 remove old pcb versions
2019-07-14 adds patch wire image for pcb v2.1
2019-07-14 adds pcb v2.2
2019-07-14 Create PCB-2.1 - Patch Wire.png
2019-07-15 Add input for rssi calibration (#81)
2019-07-19 Allow compilation without button definition (#83)
2019-07-19 Sample ADC with 6khz but only one channel at a time. (#82)
    So we have 1khz per channel.
2019-07-19 Set the time adjustment to calibrated. (#84)
    Calibration is not needed since we only have one microcontroller.
2019-07-19 Move lap logic to Laptime (#85)
    Fix undefined behavior when requesting lap 0
    [Comms.cpp, Laptime.cpp, Laptime.h]
2019-07-19 Fix compilation with serial output enabled. (#86)
    [Output.cpp]
2019-07-20 Fix include in ESP32LapTimer (#88)
    [Comms.cpp, ESP32LapTimer.ino]
2019-07-21 Redirect to main page on eeprom reset Also prevents the client from sending multiple reset requests.
    [WebServer.cpp]
2019-07-23 Multisample rssi if not in race mode This reduces noise and is useful for threshold calibration
    [ADC.cpp]
2019-07-23 Use a function to retrieve number of receivers instead of extern variable Fix typo
    [ADC.cpp, Calibration.cpp, Comms.cpp, ESP32LapTimer.ino, HardwareConfig.h, Laptime.cpp, OLED.cpp, RX5808.cpp]
2019-07-25 Redirect to main page on rssi calibration Prevents the client from sending multiple requests.
    [WebServer.cpp]
2019-07-26 Move voltage reading of the critical path (#90)
2019-07-26 Add constants for maximum and minimum RSSI ADC Fix the scaling on the OLED page.
    On full signal the bar is now completely filled.
    This also fixes the position of the threshold bar.
    [ADC.cpp, HardwareConfig.h, OLED.cpp]
2019-07-26 Prevent illegal input for map when drawing the threshold bar Fixes the threshold bar escaping the progress bar
    [OLED.cpp]
2019-07-27 Also send the last lap, when sending all laps Off by one error ;)
    [Comms.cpp]
2019-07-27 Replace hardcoded response codes with defines
    [Comms.cpp]
2019-07-28 Fix udp socket, when a client disconnects (#96)
    This also directly uses the socket to reduce the dynamic memory allocation
    [UDP.cpp]
2019-07-28 Fix race condition in output. (#94)
    Handle the sending of laps on a different core to prevent lockups.
    [ADC.cpp, ESP32LapTimer.ino, Laptime.cpp, Laptime.h, Output.cpp]
2019-07-28 Replace semaphore with notify to block the ADC task (#95)
    Uses less RAM and is 45% faster
    [ESP32LapTimer.ino]
2019-07-29 Use crc to validate the EEPROM This improves the ability to detect EEPROM coruption (even if we have no manual check) and forces a reset if the struct gets changed, but the version number is unchange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
    [HardwareConfig.h, crc.c, crc.h, settings_eeprom.cpp, settings_eeprom.h]
2019-08-10 Add comment on when to use BOARD_OLD.
2019-08-13 Prevent illegal calibration If, for whatever reason, a modules wouldn't send a value the calibration would end up with max = min = 0, which in result will cause a crash in the map function. This ensu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
    [Calibration.cpp]
2019-08-13 Move the unconfigured pin definition to target.h
2019-08-13 Fix various missing includes after removing extra includes in HardwareConfig.h This also includes renaming the VRX SPI pin definitions, so they won't clash with internal Arduino defines.
    [ADC.h, Buttons.cpp, Comms.h, HardwareConfig.h, Laptime.cpp, RX5808.cpp]
2019-08-16 Add note about calibration on the webpage Seems like recently there has been a bit of confusion regarding the calibration.
2019-08-16 Set the default calibration to the configured max and minimum ADC values.
2019-08-20 Fix handling of packets containing multiple commands
    [Comms.cpp, Output.cpp]
2019-08-22 Add support for TCP connections. First tests suggested this is far superior to using UDP, but further testing is required. Currently disabled by default.
2019-09-03 Fix crash in serial output module
    [Serial.cpp]
2019-12-24 Restore Arduino compatability
2020-03-14 Fix enumeration According to the documentation only the highest value is sent. Fixes compatability with racegod Thank you @realhuno
    [Comms.cpp]
2020-03-14 Fix messed up cherry-pick
    [Comms.cpp]
2020-03-15 Fixes overflow in constant (#105)
    [Comms.cpp]
2020-03-23 Adding support for wifi client mode (#106)
    * Adding new files for wireless config
    * Removing code that's now in Wireless.cpp
    * Removing unused code
    * Renamed function to better reflect purpose
    * Updating file to reflect new handling of WiFi and HTTP
    * Adding new Wireless header
    * Adding code for running as a WiFi client
    * Adding new configuration options for WiFi modes
    * Modifying start up and loop code to enable different wifi modes.
    * Fix naming conflict
    * Fix undefined variables
    * Correcting the definition of DNS_PORT
    * Changing from serial prints to esp-idf logging
    * Cleaning up Wireless.h
    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
    [ESP32LapTimer.cpp, HardwareConfig.h, TimerWebServer.cpp, TimerWebServer.h, Wireless.cpp, Wireless.h]
2020-03-23 Simplifying some pin logic and addressing a consistency issue (#107)
    * Changing to upper case for consistency
    * Simplifying CS pins logic
    * Simplifying ADC pins logic
    * Added checking for potential overflow
    * Adding basic sanity check to write
    [ADC.cpp, Comms.cpp, HardwareConfig.cpp, HardwareConfig.h, Laptime.cpp, RX5808.cpp, TimerWebServer.cpp, settings_eeprom.cpp]
2020-03-29 Add support for (emergency) OTA mode (#109)
    * Add support for emergency OTA mode
    * Add protection for manual reboot loop
    [Buttons.cpp, CrashDetection.cpp, CrashDetection.h, ESP32LapTimer.cpp, HardwareConfig.h, TimerWebServer.cpp]
2020-05-23 Add pcb based on the esp32-wroom-32u (#120)
    [esp32-wroom-timer.kicad_pcb, esp32-wroom-timer.sch]
2020-05-23 Fix crash mode detection
    [CrashDetection.cpp]
2020-05-24 Spi fixup (#121)
    * Fixes CS pins being in the wrong initial state
    * Removes unnecessary rx setup
    * Fixes web interface bug
    This fixes the band/channel on the first rx being reset every time it was updated
    [HardwareConfig.cpp, TimerWebServer.cpp]
2020-05-24 Moves the tune time to after the spi transaction is complete (#122)
    The system should probably signal that it's done before waiting for the module to complete the switch
2022-05-30 fix incorrect variable order (#126)
    [TimerWebServer.cpp]
